kuniTN/rescue_tanaka_works/kicad/project/switching_board/screen shots/溶着画像2.jpg

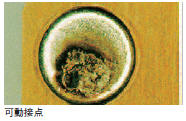
kicad/project/switching_board/screen shots/溶着画像2.jpg
