kuniTN/rescue_tanaka_works/kicad/project/switching_board/reference/ref3_トランジスタ・FETの選定_files/97f2e41f8781f32b32655e35a1a60c25.png

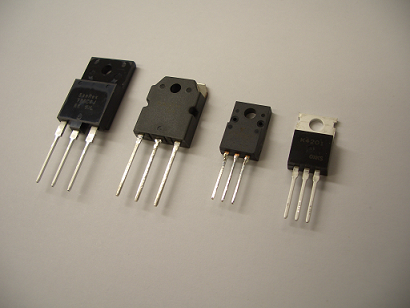
kicad/project/switching_board/reference/ref3_トランジスタ・FETの選定_files/97f2e41f8781f32b32655e35a1a60c25.png
