kuniTN/rescue_tanaka_works/README.md

# rescue_tanaka_works
 ここでは田中がレスキューロボット開発で身に着けてきた知見をもとに，今までの回路やプログラム等々を再設計，解説しています．
 新潟大学の非産業用ロボットプロジェクトの皆さんの基礎的な知識として身に着けていけるよう，なるべくわかりやすく解説をしていこうかと思っています
