kuniTN/rescue_tanaka_works/kicad/project/switching_board/スイッチング基板解説書.docx

1. はじめに

本ドキュメントは，[スイッチング基板_回路図v1.1.0_20210707.pdf]の回路についての
設計解説書です．

この回路は非産業用ロボットプロジェクトで開発中のレスキューロボット内に搭載することを“想定”し，既存の回路を再設計したものです．この回路はまだ作成・組込まれていないことに留意してください．

本ドキュメントでは，スイッチング基板について以下の項目を取り上げます．

- 基板の役割
- 回路設計
- 製造上の注意
- 設計者の考える追加改良案

電気的知識があまりない人にも可能な限り分かりやすく説明しているつもりです．

本ドキュメントの内容に関して不明点等あれば以下までご連絡ください．

送信先：田中邦明　アドレス：tkknnka1114@gmail.com

# 2. 基板の役割

## 2.1. ロボット全体における基板類の概略

まず基板の説明をする前に，図1にロボット全体の基板類の概略図を示します．

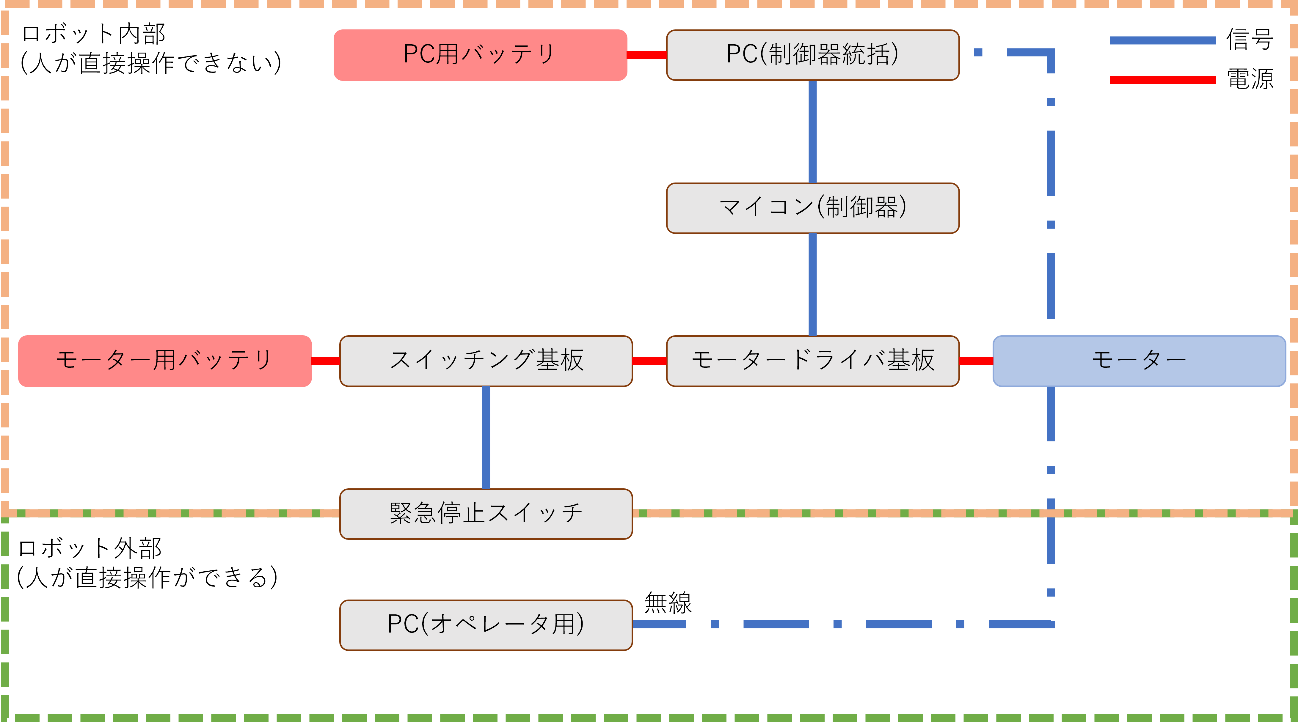
[picture p3: figure]

図1　ロボットシステム概略図

この中でスイッチング基板が接続しているのは

- モーター用バッテリ
- 緊急停止スイッチ
- モータードライバ基板（モーターを制御する基板）

の3つです．緊急停止スイッチが操作されたとき，バッテリからモータードライバ基板への電力供給が遮断され，ロボットが停止するようになっています．

## 2.2. スイッチング基板の役割

レスキューロボットに採用している緊急停止スイッチは図2のように，通常時は導通しており，緊急時にはスイッチを押し込むことで切断する仕組みになっています．

(大半の緊急停止スイッチはは押して切断するNCタイプですが，稀にそうでないものも)

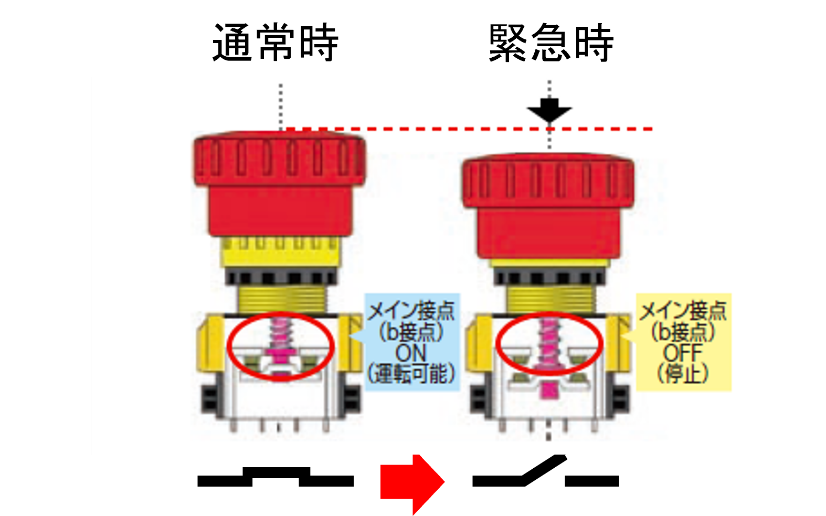
[picture p4: figure]

図2　緊急停止スイッチ内部構造

ならば，バッテリを直接緊急停止スイッチにつなげても同じことになるのでは？と考える人もいると思います．しかし，図3のようにつなげるのは場合によっては危険です．

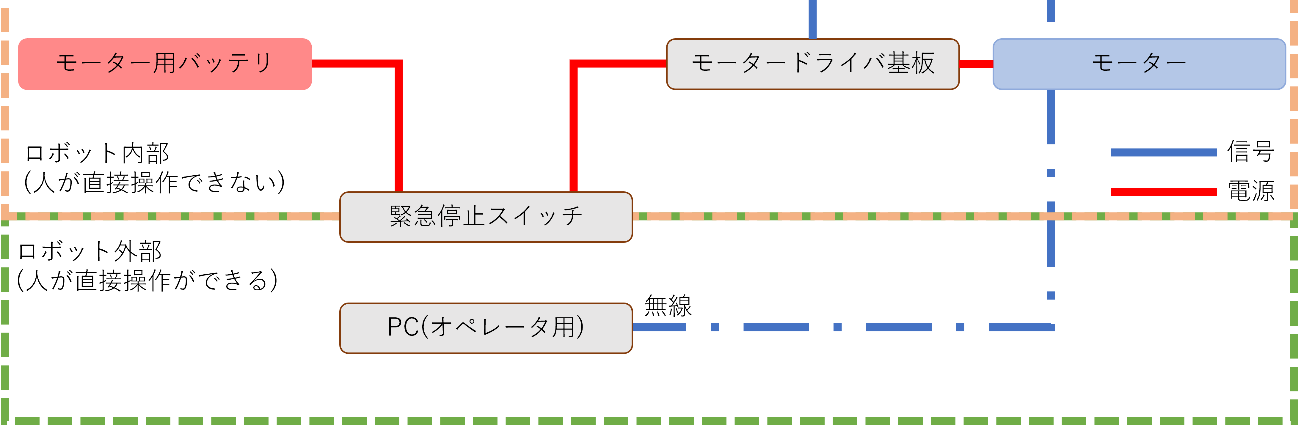
[picture p5: figure]

図3　バッテリ接続のダメな例

なぜダメなのでしょうか？それは，スイッチにも流せる電流の上限があるからです．

機械的な構造を持つスイッチは，接点部に抵抗があります．そのため電気が流れる際に接点部で発熱します．大電流が流れると異常発熱し，接点同士が溶けてくっついてしまう，つまり常にON状態に陥ります．そうなってしまってはスイッチの意味がありません．

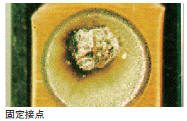
[picture p6: figure]

モーターは，動かすのに非常に大きな電流 (数A以上) が必要です．そのためバッテリとモーターの間に機械的スイッチをつなげてしまうと，スイッチを壊してしまう可能性が非常に高いです．

図4　スイッチ接点の溶解の様子

そこで大電流が流れる回路でもスイッチングを行うために，“電気的”スイッチを利用します．その名の通り，電気で電気のスイッチ操作するわけです．このような機能を持つ素子のことをトランジスタといいます．

トランジスタは機械的な構造を持たないので接点がなく，大電流のスイッチングを小電力で行うことができます．

（ここではトランジスタの原理については説明しません．
インターネット上に様々な解説資料がありますので，参考にしてください ）

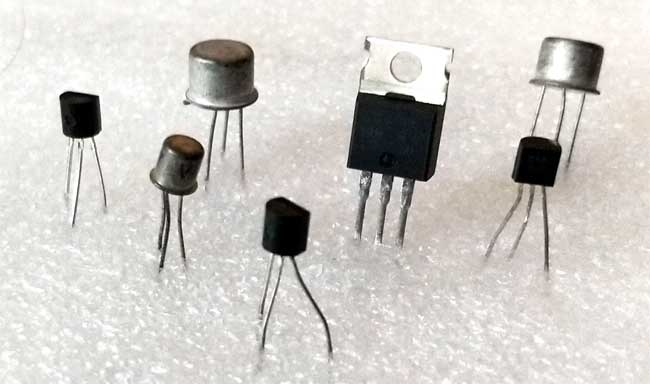
[picture p7: figure]

図5　トランジスタ

スイッチング基板はつまり，機械的スイッチで電気的スイッチの操作を行い，電気的スイッチがバッテリからの大電流を制御する基板です．こうすることで初めて，人が操作しやすい機械的スイッチを使って大電流を制御できるようになるわけです．

# 3. 回路設計

ここからは，設計者が作成した回路と合わせて詳細に説明していきます．

この回路は大きく分けて3つの領域に分かれています．

[スイッチング基板_回路図v1.1.0_20210707.pdf]を開き，適宜拡大等して確認してください．

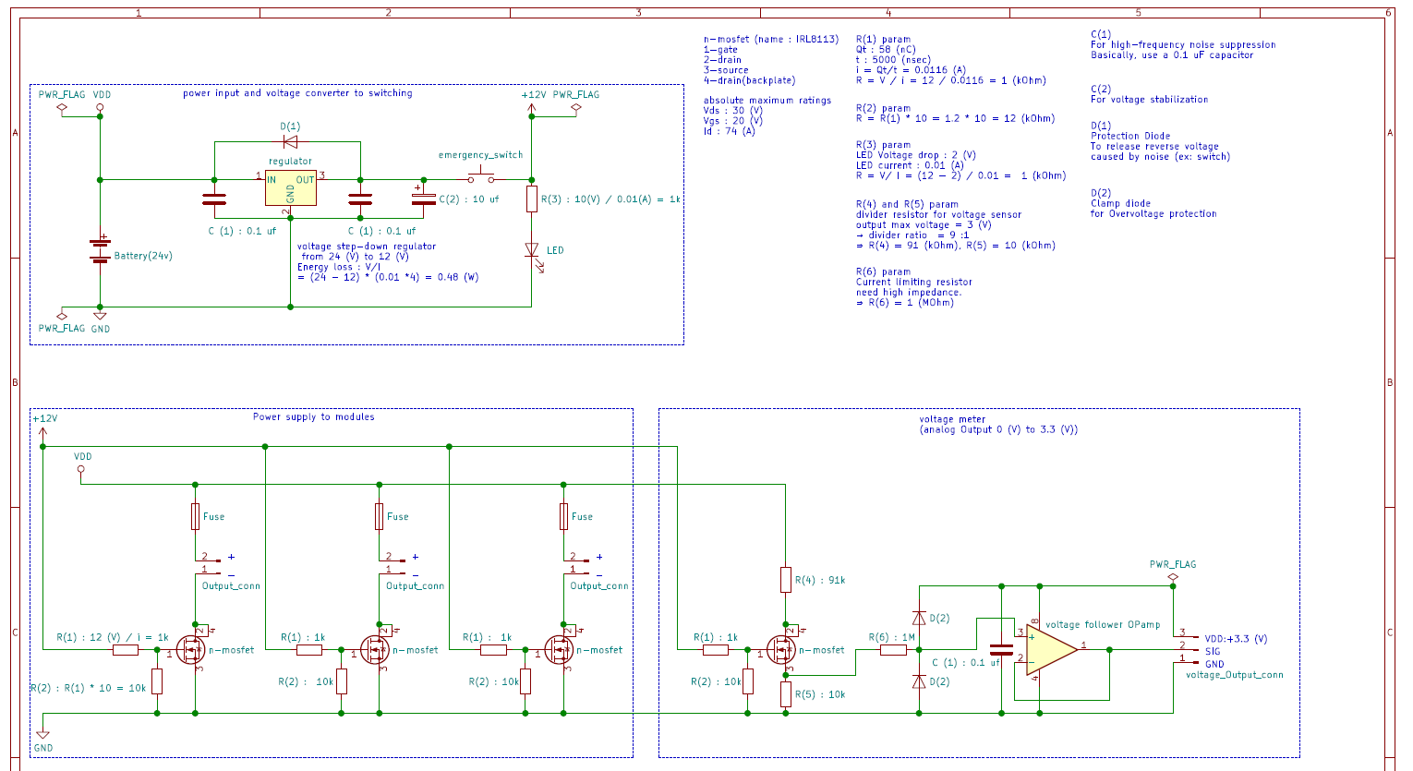
[picture p8: figure]

図6　回路図全体

## 3.1. 電源出力

まずはこの基板における最重要区画，電源出力部を見てみます．

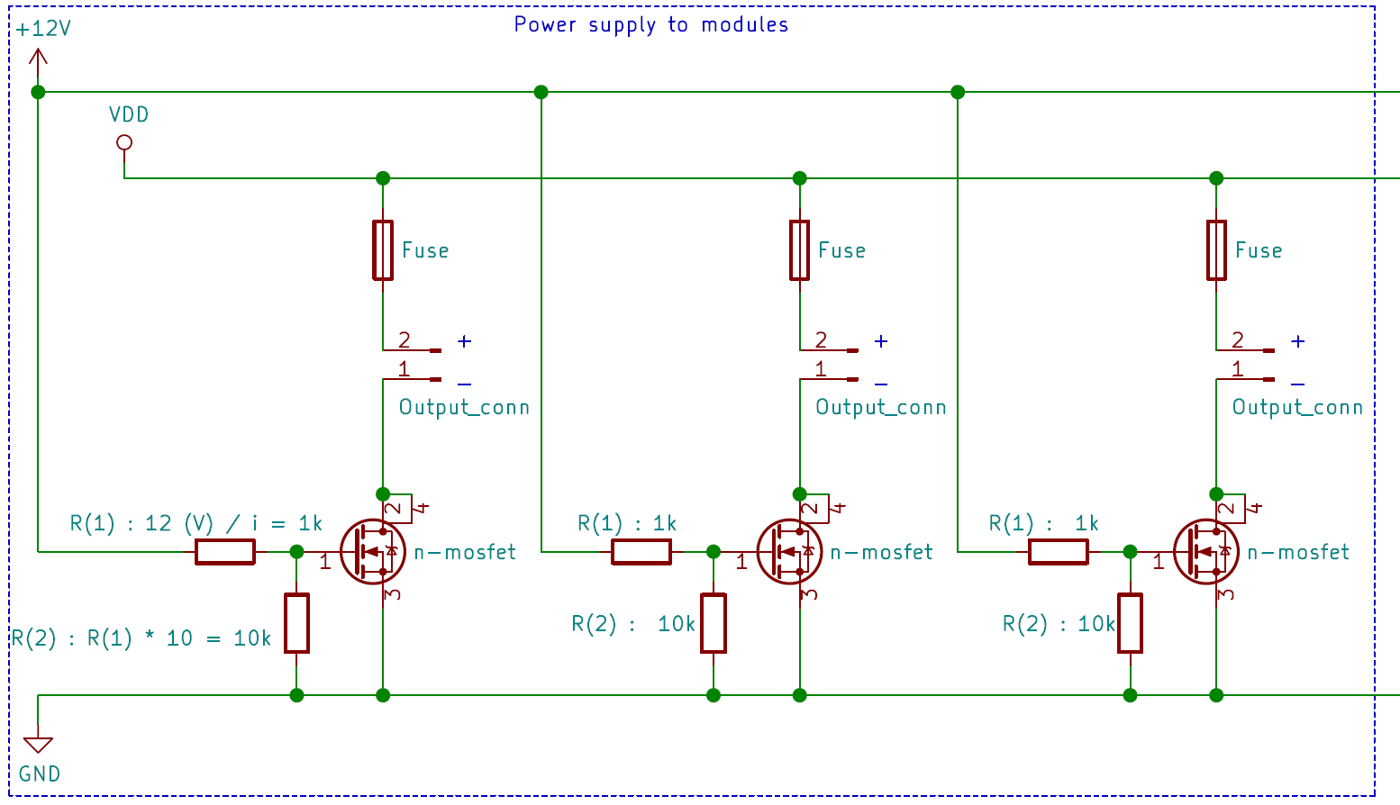
[picture p9: figure]

図7　電源出力部

この回路では，電源出力コネクタ(Output_conn)を3つ用意しています．このコネクタからモータードライバへ電力を供給します(図8)．

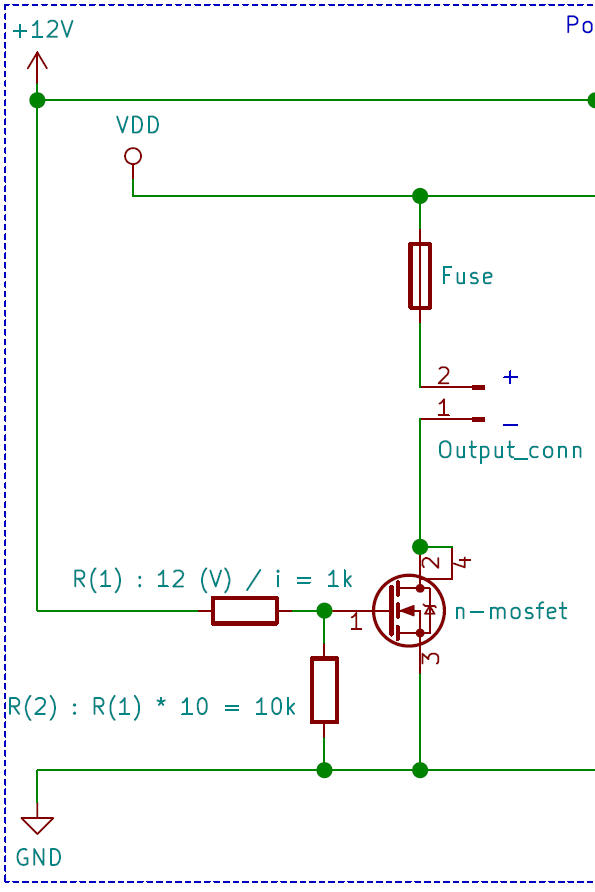
[picture p10: figure]

モーター

モータードライバ基板

図8　電源出力部(1 unit)

### 2.1.1 n-MOSFET

この基板における最重要素子でトランジスタの一種です．この素子によって電源のスイッチング操作を行います．

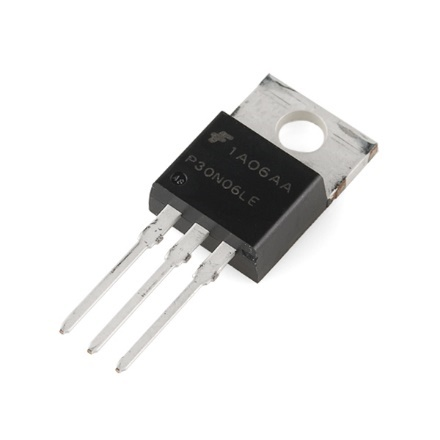
[picture p11: figure]

図9　MOSFET

MOSFETには2種類 (P channel, N channel) あります．どちらもスイッチング可能な素子ですが，若干使い方が異なります．普通に使う分にはN channelの方が使いやすいと思いますので，ここではN channelのMOSFETのみ解説します．

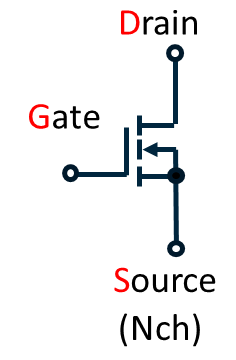
[picture p12: figure]

図10　n-MOSFET回路記号

n-MOSFETは，図9からわかる通り3つの端子が出ています．これらはそれぞれ，Drain, Gate, Sourceの端子となっています．モーター用バッテリの電流はDrainからSourceにかけて流れ，その流れをGate-Source間電圧によって制御します．

⇒　Gate-Source間電圧が0 V であればDrain-Source間は遮断

Gate-Source間電圧が閾値以上であれば，Drain-Source間が導通

MOSFETを選定する際には，耐圧，耐電流，Gate-Source間の閾値電圧に注意してください．この回路で使用を想定したIRL8113であれば，Drain-Source間の最大耐電圧は30V, 耐電流は74 A, Gate-Source間の耐電圧は20 V，閾値電圧は1.35 ~2.25 Vです．

参考サイト : https://ana-dig.com/transistor_fet/

### 2.1.2 ゲート抵抗

参考サイト : https://ana-dig.com/fet_gate1/

参考資料 : TOSHIBA MOSFET設計 (https://toshiba.semicon-storage.com/content/dam/toshiba-ss-v2/master/en/semiconductor/knowledge/faq/mosfet/MOSFET-Gate-Drive-Circuit-Application-Notes_JA_3626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)

n-MOSFETを使用するためには，Gate-Source間に電圧をかける必要があることを前項で説明しました．ここで回路全体を見ると，n-MOSFETには2つの抵抗が接続されていることがわかります．この項では，下図に示されている，スイッチからの
12 VとGate間に接続されている抵抗（ゲート抵抗）について解説します．

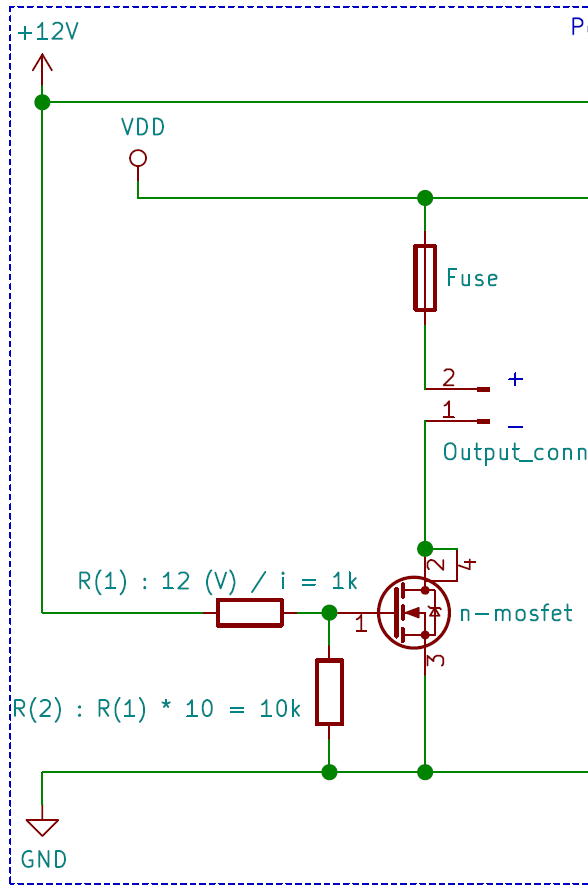
[picture p13: figure]

ゲート抵抗

図11　ゲート抵抗の位置

n-MOSFETのGate-Source間はコンデンサのような働きを持ち，このコンデンサが閾値電圧( V_(GS(Th)) )以上になった時，Drain-Source間が導通すると理解してください．
下図はn-MOSFETを他の素子で簡略的に示したものです．

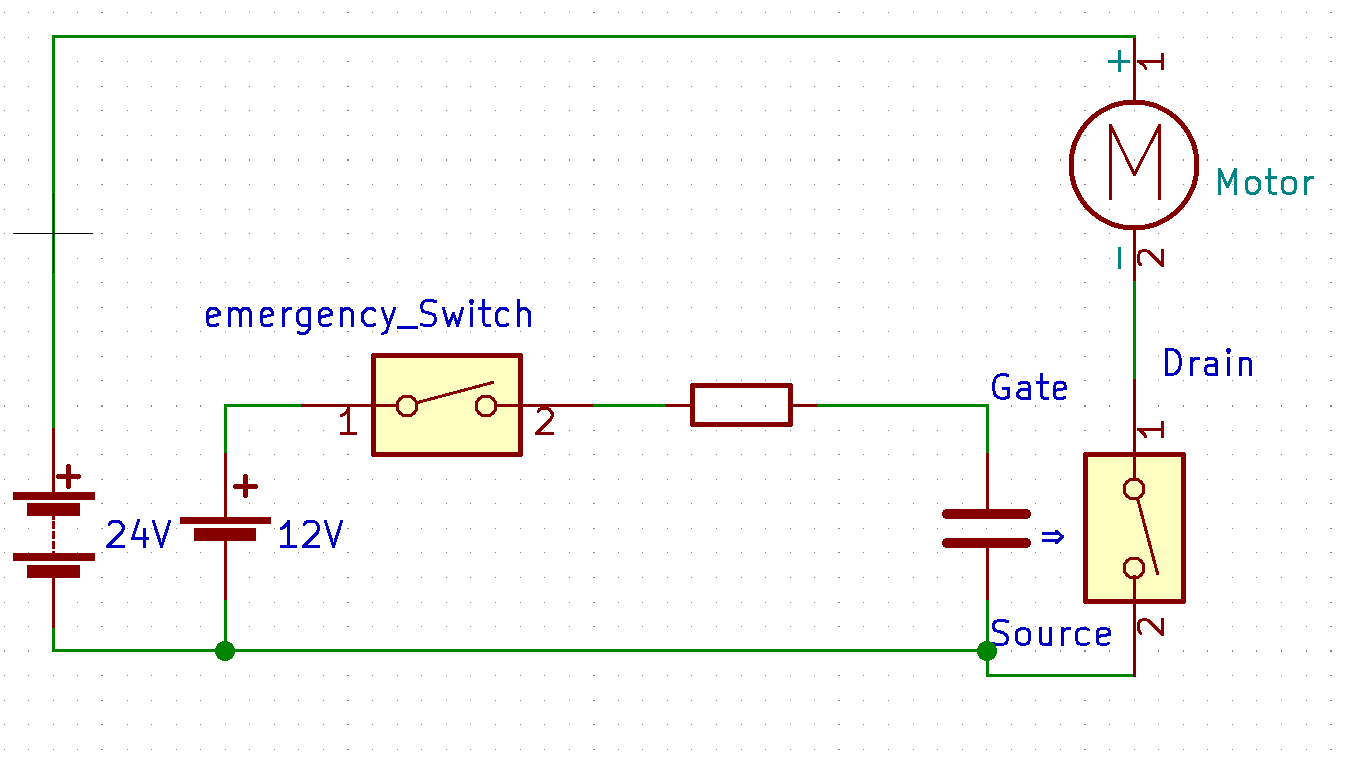
[picture p14: figure]

ゲート抵抗

if V_(GS) >V_(GS(Th)) :On

V_(GS)

図12　n-MOSFETの概略

ここでコンデンサの働きについて確認しましょう．

直流電源におけるコンデンサは，充電が空っぽの時，抵抗値は0（短絡）として考え，満充電の時の抵抗値は無限大（解放）と考えます．

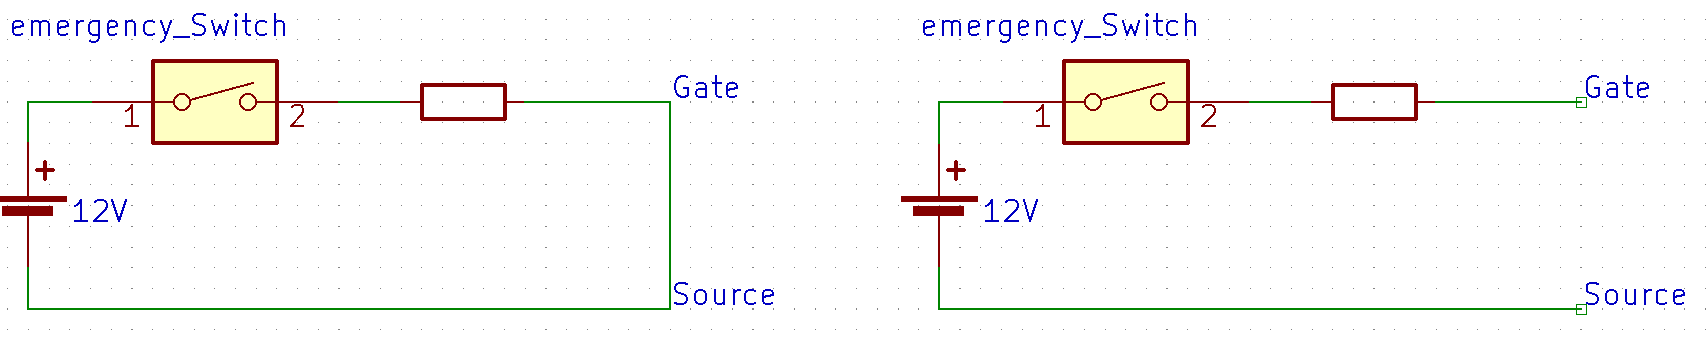
[picture p15: figure]

図13　コンデンサの充電状態による回路表現
左：コンデンサが空　右：コンデンサ満充電

仮にゲート抵抗がない場合，コンデンサが空ならば，バッテリがショートしていると考えることができます．この状態は無制限に電流を流せるということであり，バッテリが異常発熱したり回路を焼損させたりする要因になり非常に危険です．スイッチング用の電源回路(ドライブ回路)の保護のためにゲート抵抗が必要というわけです．

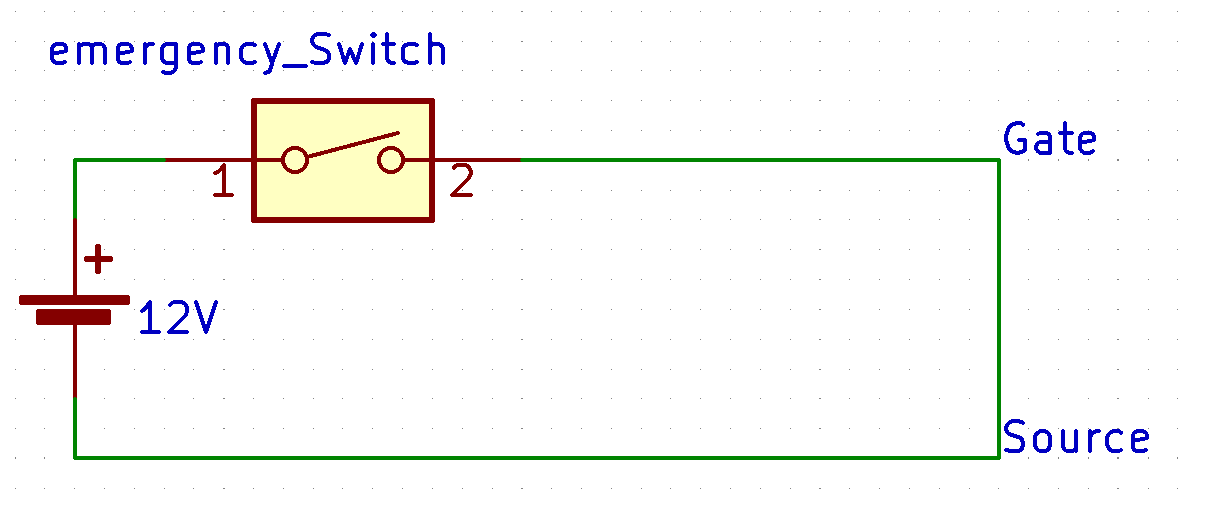
[picture p16: figure]

図14　バッテリがショートしている危険な状態

このようなつなぎ方をしては絶対にダメです

では次に，どの値の抵抗を使えばよいのかについて説明します．

先ほどn-MOSFETのGate-Source間はコンデンサのような役割を持つことを説明しました．コンデンサの充電速度は流れ込む電流量によって変化します．コンデンサの充電が早ければそれだけ早くDrain-Source間は導通します．

コンデンサの充電時間を計算するためには，Gateの電荷量 Qg を見ます．

n-MOSFETのデータシートより， Q_g -V_(GS) グラフを確認します．今回はIRL8113のパラメータを確認します．

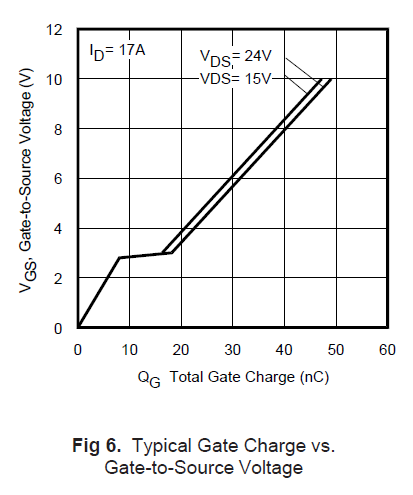
[picture p17: figure]

図15　n-MOSFETの Q_G -V_(GS) グラフ

今回の回路では， V_(GS) に12 Vを印加します．図15より， V_(GS) が12 V付近の Q_G を見ると，およそ58 nC と読み取れます．

(グラフが途中で切れているように見えますが，一般的にMOSFETは V_(GS) が10 Vで駆動することが基本のようで，このデータシートではそこまでしか記入されていないようです．今回の場合は直線を延長して考えて問題ありません)

Q はある電流 I をある時間 t だけ流した時の電荷量であり，(1)式で表されます．

, Q=I*t (I:電流量， t :時間)#(1)

ここからわかるように， Q_G が与えられている今，充電時間あるいは流す電流量を決定すればもう一方の変数が一意に定まります．今回は時間を5000 nsecと定めてみましょう．すると計算結果は(1)式より

, I_G =(Q_G)/t=(58*10^(-9))/(5000*10^(-9))=0.0116 (= 11.6 mA)#(2)

よって，(2)式よりGateに流れ込む電流量が11.6 mAとわかりました．

今回は時間 t を5000 nsecと定めましたが，この値は今までの制作経験則からであり，また最終的に計算結果の電流量が約10 mA程度になる範囲として定めたので，かなり適当です．精度が必要な回路であれば厳密に決定すべきでしょうが，今回は接続される機器にそこまで電気的な精度が求められていないので，ある程度適当で問題ありません．逆に電流量を定め，それにかかる時間を計算しても構いません．

(10 mAを流すと定めるなら，充電時間が5800 nsecとなります)

詳細な設計を行いたい場合はTOSHIBAの参考資料をご覧ください．

必要な電流量が求まったら，あとは単純なオームの法則で解くことができます．

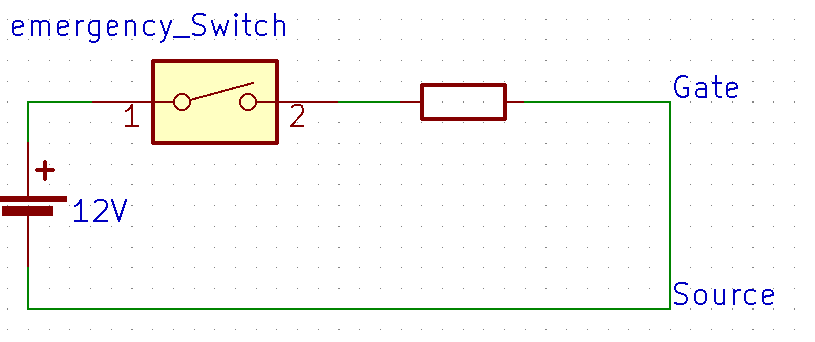
[picture p18: figure]

I=11.6 mA

図16　抵抗値計算

図16を見れば単純ですね．オームの法則(3)式より

, R=V/I=12/(11.6*10^(-3))=1034.4 ≈1 kΩ#(3)

この計算結果から，実際に販売されている抵抗を選択し， 1 kΩ をゲート抵抗として使用することが決定しました．

### 2.1.3 ゲートソース間抵抗

参考サイト : https://ana-dig.com/fet_gate2/

https://detail-infomation.com/mosfet-gate-to-source-resistor/

つぎにGate-Source間に並列して接続されているゲートソース間抵抗を考えます．

前項では，ゲートソース間抵抗はないものとして取り扱っていました．それはこの抵抗が持つ役割がゲート抵抗とは全く異なり，またゲート抵抗に対して非常に高い抵抗値のため電流路への影響が非常に小さいためです．

ゲートソース間抵抗

図17　ゲートソース間抵抗の位置

ゲートソース間抵抗の役割は，回路の安定性を高めるためです．

簡単な思考テストをしてみましょう．

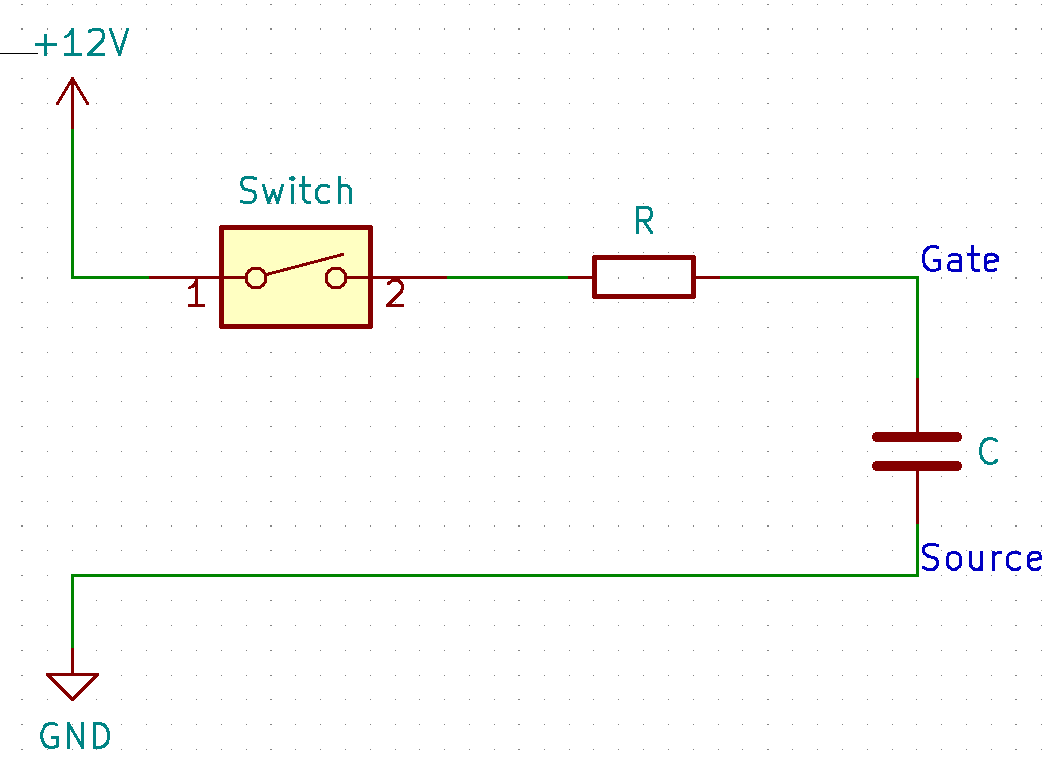
[picture p19: figure]

V_(GS) = ???

図18　n-MOSFET等価回路

図12の回路上のスイッチがオフ，つまり回路がつながっていない場合を考えます．

スイッチがオフだからといって，Gateの電圧が0Vとなることが決まるわけではありません．そもそも電圧の基準となる0 VというのはGND線の電位のことであり，高電位をもつ電圧源からGNDにつながる回路があって初めて電圧が決まります．スイッチがオフであるため，回路として不成立であり，そもそも電圧を規定できません．このような状態を電気回路の世界では配線が「浮いている」と表現する様です．

また，Gate-Source間をコンデンサで表現したように，Drain-Source間のスイッチをオフにするためにはコンデンサ内の電荷を逃がしてやる必要があります．しかし図12の回路ではコンデンサにたまった電荷を逃がす経路が存在しません．

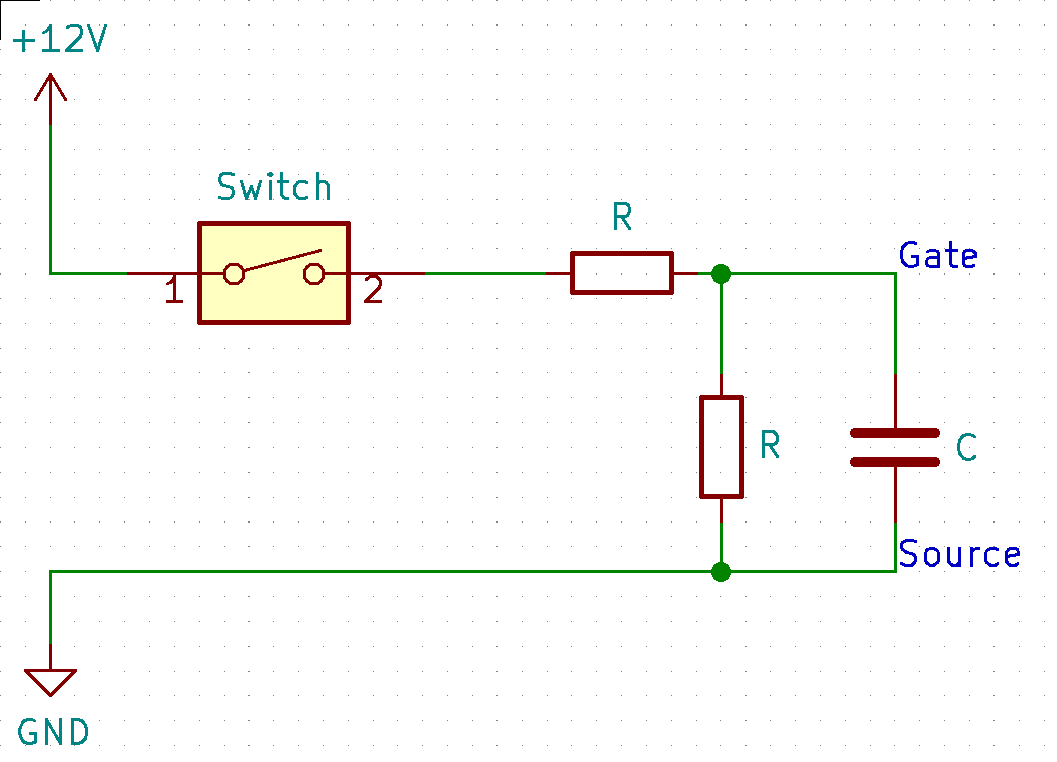
[picture p20: figure]

コンデンサからの放電

図19　ゲートソース間抵抗つき回路

図19のように，ゲートソース間と並列に抵抗をつなげることで，スイッチがオフになったとしても，ゲートソース間のコンデンサにはGNDとつながる経路が出来上がり，コンデンサの電荷を逃がすことができ，Gateへの電位を0Vに保つことができるようになります．この抵抗があることで，n-MOSFETを確実に電源オンオフできるようになります．

では次に，どの値の抵抗を使えばよいのかについて説明します．

初めに説明したように，この抵抗は電流を流すことを目的とはしていません．
そのため電流はあまり流さず，電圧は小さくなるようにゲート抵抗に対して十分に大きい抵抗値に設計します．

大きすぎると今度はコンデンサからの電荷の放出に影響を与えるため，ある程度の大きさにとどめる必要があります．

まず，ゲート電圧 V_(GS) の電圧とドレイン電流 I_D のグラフを見て， V_(GS) に印加する電圧の下限を検討します．

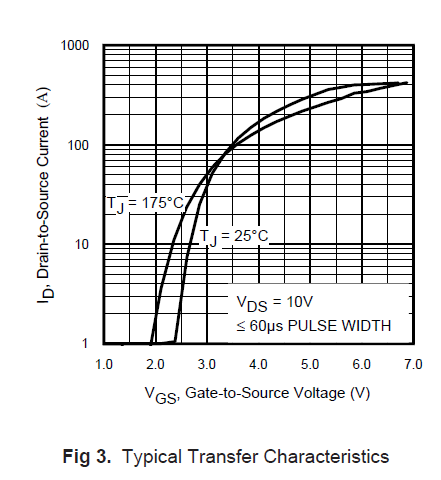
[picture p21: figure]

図20　 V_(GS) -I_D グラフ

図20より， V_(GS) が7V以上ならば， I_D が飽和することがわかります．ですので， V_(GS) の最低電圧を7 V とし，抵抗値を決定してみましょう． V_(GS) の電圧源は12 V なので，ゲート抵抗 R_G とゲートソース間抵抗 R_(GS) の比は，分圧の関係から
, R_G :R_(GS) =5:7#(4)

と定まります．今回 R_G は前項より1 kΩ と定めたので， R_(GS) は最低1.4 kΩ にすればよいです．しかし，この抵抗値は最低限ですので，これよりも大きい抵抗値を設定しておけば， V_(GS) が7 Vを下回ることはありません．

参考サイトではつぎに， V_(GS) の電圧源が流せる電流量について検討していますが，今回の場合は，ここで用いる電流量の限界はひとまず無視できるものとして考えます．もしスイッチング用電圧源をマイコン等から供給する場合はここも十分に検討しましょう．

次に，ドレインに急激に電圧が加わった時に流れてしまうノイズ電流の影響を検討します．しかし，ノイズ電流が実際どれくらい流れるかは不明です．そのため，ある程度の抵抗値を設定しておき，エラーが発生した際に調整するのが現実的と思われます．

以上より，(4)より R_(GS) には最低1.4 kΩ の抵抗を用いればよいことがわかります．今回はゲート抵抗 R_G の10倍の値として10 kΩ と定めました．この抵抗値であれば V_(GS) が閾値を超えるために必要なノイズ電流は0.15 mAとなります．

バッテリ電源を印加したとき，一瞬モータードライバに電源が入る場合はノイズ電流で V_(GS) が閾値を超えてしまっていることになるので， R_(GS) の抵抗値をより小さくする必要があります．

### 2.1.4 ヒューズ

参考サイト : https://www.socfuse.com/ja/technical-info-data/3509/

この回路には各MOSFETにヒューズを搭載しています．このヒューズの目的は，モータードライバへの出力段以降で発生したショートなどに対する対策として取り付けています．バッテリ保護用ではないことに注意してください．

ヒューズの選定は，本来であれば非常に厳密な測定に基づいて決定されるべきものです．（参考サイトをご覧ください）

ですが現時点でヒューズの選定に必要な情報はほぼ得られていません．各モータードライバ以降で消費する電流，電圧の時系列データが必要ですので，今後それらの計測が必要です．現時点ではお守り程度に思っておいてください．

## 3.2. 電源入力

電源入力を受ける部分は以下の回路図になっています．

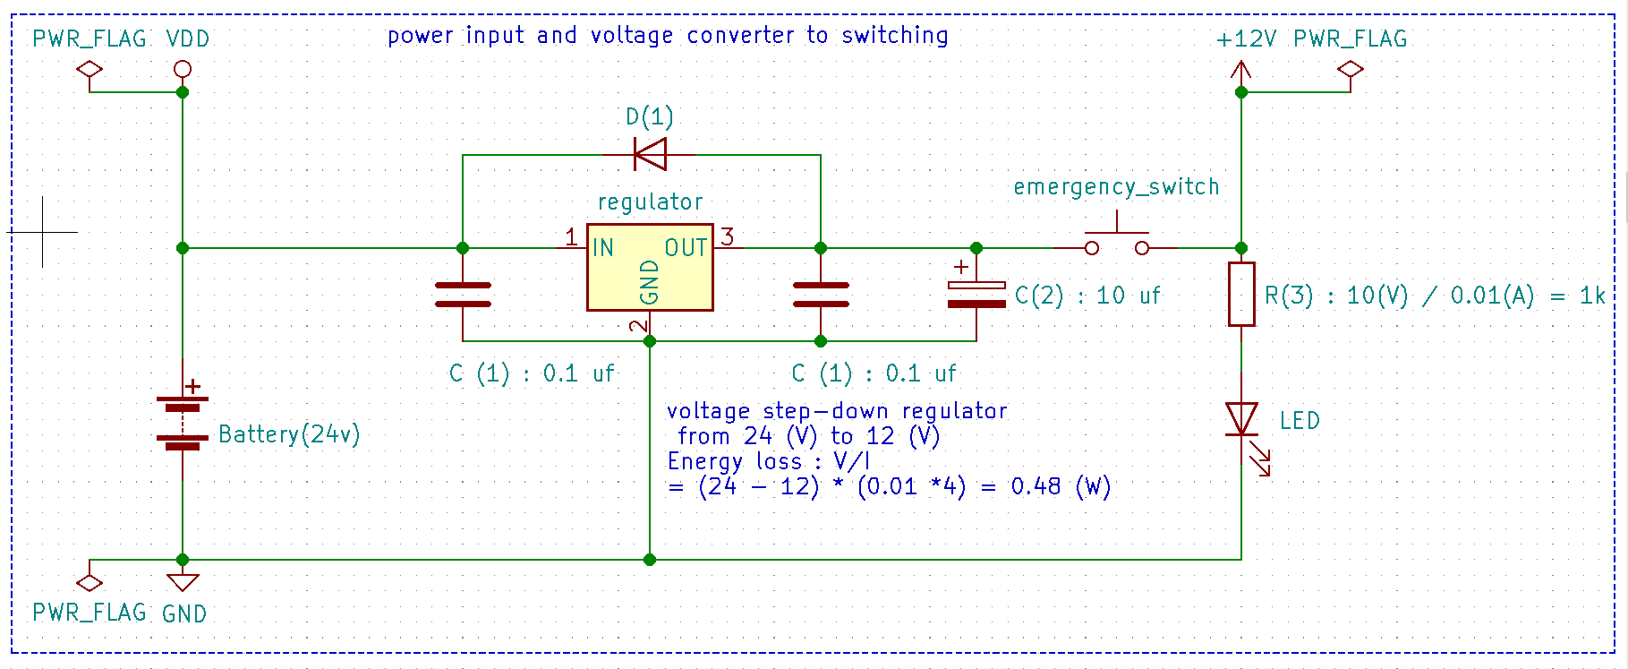
[picture p22: figure]

図21　電源入力段　
(回路上のPWR_FLAGは回路には無関係です)

画面左側にあるBatteryがモーター用に用意しているLi-Poバッテリです．ここからVDDにつながり，前項で説明したMOSFETのDrainへ流れ込みます．

ここではバッテリから右側へつながっていっている回路について解説します．

### 3.2.1. 3端子レギュレータ

図22　3端子レギュレータの位置

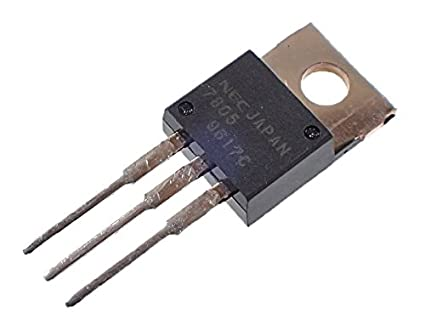
[picture p23: figure]

図23　3端子レギュレータ

図22の丸で囲んだ部分が図23に示された3端子レギュレータと呼ばれる素子です．バッテリの右側回路は基本的にすべてこの端子を動かすために必要なコンデンサ類です．

3端子レギュレータとは，入力された電圧を，指定された電圧に変圧してくれる
素子です．今回はバッテリからの24 Vを12 Vに降圧するために用いています．

なぜ12 Vに降圧しているのか？それは使用しているn-MOSFETの V_(GS) 絶対定格が最大 20Vであったためです．バッテリからの電圧をそのまま入力してしまうとn-MOSFETを破壊してしまうため，降圧する必要があるわけです．

降圧するだけなら，分圧用の抵抗を直列つなぎにしてもよさそうですが，今回の電圧源であるモーター用バッテリは，モーター駆動時に大電流を流すため，一時的に電圧が大きく変動します．この時，降圧する為に抵抗を用いていた場合は，その電圧変動の影響を直接受け，結果としてn-MOSFETの動作を不安定化させてしまいます．これを防ぐために安定的に電圧を供給することのできる3端子レギュレータを採用しました．

3端子レギュレータの両端にはコンデンサがついています．これらはどちらも電圧安定化，ノイズ除去のための素子です．本来ならば，左側にももう一つ容量の大きいコンデンサを配置したいところですが，先ほど説明した通りモーター用バッテリは，モーター駆動時に大電流を流すために電圧変動が大きく，多少容量の大きなコンデンサを配置してもあまり効果をえられないと考えられたので省略しています．

（ノイズ除去用コンデンサについての詳細はここでの説明は省きます．基本的には使用する3端子レギュレータの仕様書に従って問題ありません．）

### 3.2.2. LED

LEDがemergency Switchの後に接続されています．このLEDはモータードライバ等への電源供給が行われていることを示すインジケータです．

LEDの抵抗値の決定は，LEDの電圧降下を意識して設計する必要があります．LEDは一般に1~2 Vの電圧降下を引き起こします．今回LEDへ与えられる電圧は12Vですので，抵抗にかかる電圧は12 – 2 = 10 V です．今回LEDへ流れる電流は10 mAと定め，抵抗値はオームの法則より，1 kΩ としました．

## 2.3 電圧監視回路

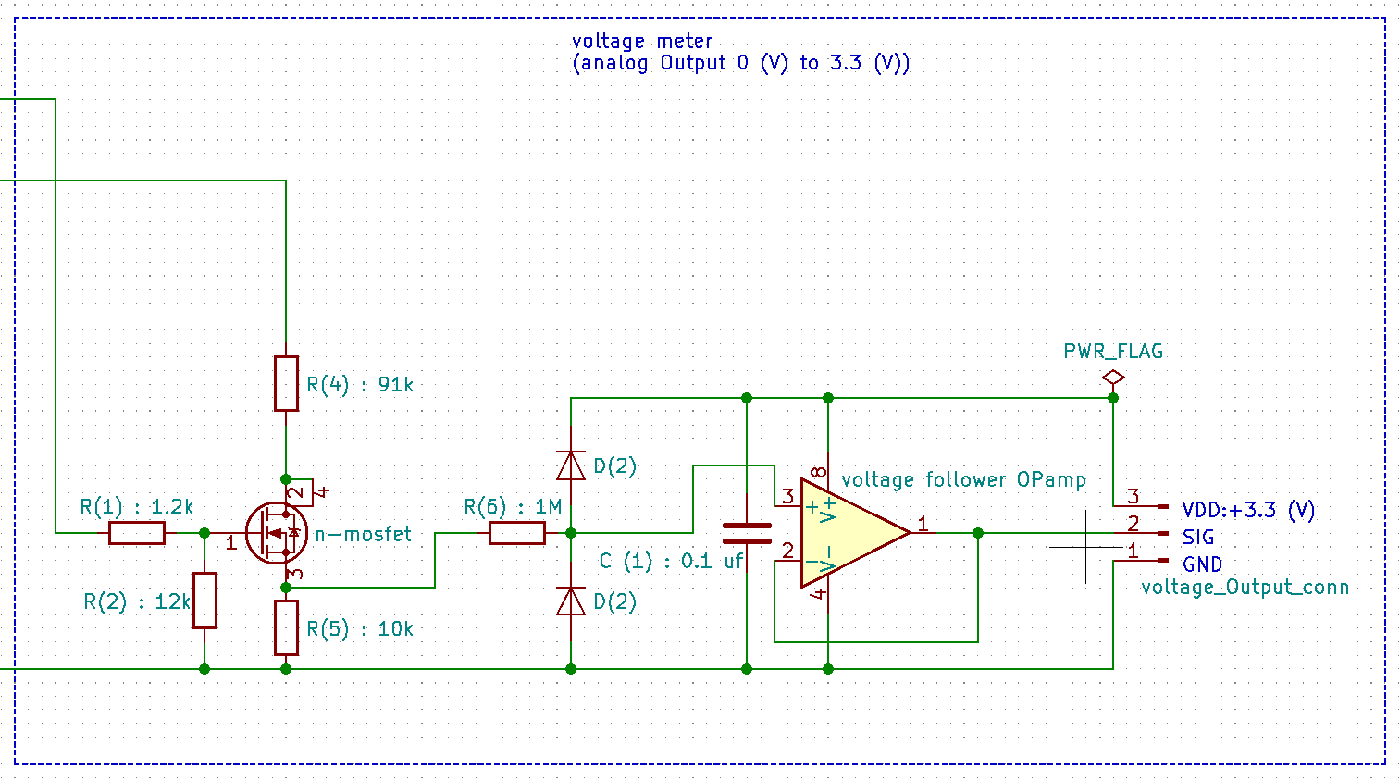
[picture p24: figure]

図24　電圧監視回路

電圧を監視するために作成した回路です．この回路は大きく分けて次の3つの回路に分割されます

- 分圧回路
- クランプ回路
- ボルテージフォロア回路

クランプ回路，ボルテージフォロア回路は両方ともマイコン保護用回路です．

それぞれ確認しながら解説します．

### 2.3.1. 分圧回路

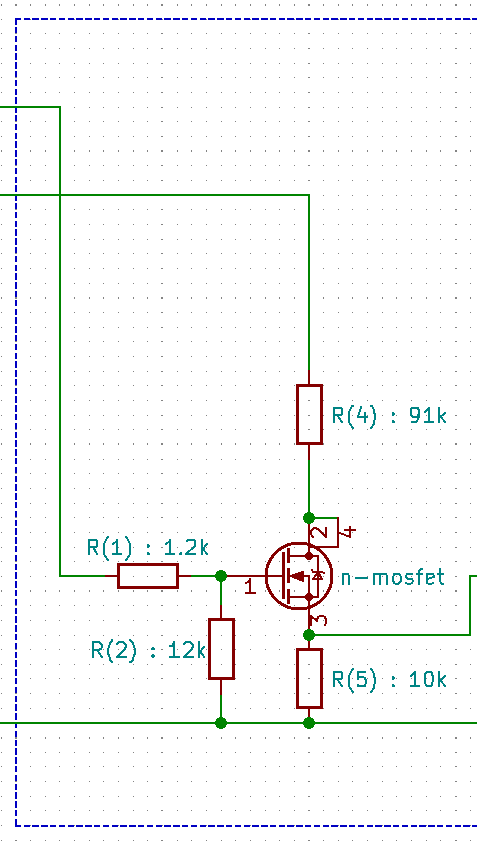
[picture p25: figure]

図25　分圧回路

2.1章で解説したn-MOSFETを利用した回路で，ヒューズを排し，その代わりに抵抗が２つ導入されています．

この２つの抵抗は，およそ9:1の比になるように設計しています．これは入力電圧が最大30Vの時，出力電圧が3 Vになるようにするためです．入力電圧を最大30Vとしたのは，安全率のためです．マイコンが壊れると制御系がすべてダウンしてしまうため，余裕を持った安全率を設定する必要があります．また出力電圧が3Vとした理由は，マイコンが計測できる電圧値の範囲が0~3.3 Vとなっているためです．

ここはただの分圧回路ですので解説は省略します．

### 2.3.2. クランプ回路

参考資料 : A-Dコンバータとアナログ入力のインターフェース (https://www.cqpub.co.jp/hanbai/books/42/42101/42101_6syo.pdf)

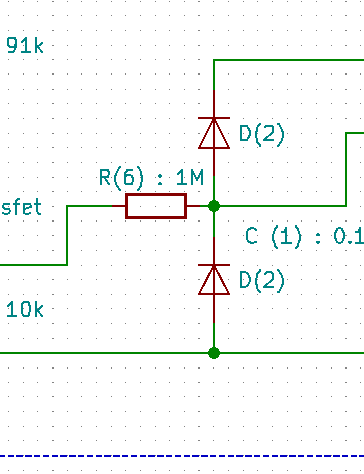
[picture p26: figure]

入力

GND

出力

3.3 V

図26　クランプ回路

入力から出力への経路を赤い線で示す

クランプ回路とは保護回路の一つで，入力された電圧を，設定した電圧の範囲に補正する回路です．図26のように，入力から出力への経路を二つのダイオードで挟み込む(クランプ)ような形となっています．入力から出力の電圧は前述の通り基本的に0~3Vとなっているので，二つのダイオードは逆方向の電圧がかかっています．そのため基本的にはこれらのダイオードは働きません．

これらのダイオードが働くのは，入力電圧が0Vを下回るとき(逆電圧)，あるいは3.3Vを上回るときです．先の設計が正しく働いていれば，これらの電圧になることはありませんが，何かしら異常が発生した場合はこれらの電圧を超えることが考えられます．その時にはそれぞれのダイオードが順方向となり電流が流れだし，電圧を変化させます．その結果として出力電圧を0~3.3Vの範囲内に収めることができます．

入力から出力の経路内に存在する抵抗は，電流制限用の抵抗です．この後解説するボルテージフォロア回路には(理論的には)電流が流れません．そのため通常は電流が流れませんが，先ほどの保護回路が働く際には電流が流れます．ただし，この電流が流れることによって，前段の分圧抵抗のインピーダンスが低くなり，正確な電圧計測ができなくなります（後述）．そのためなるべく電流を流さないように非常に大きい抵抗を用いています．

### 2.3.3. ボルテージフォロア回路

参考サイト : https://detail-infomation.com/voltage-follower/

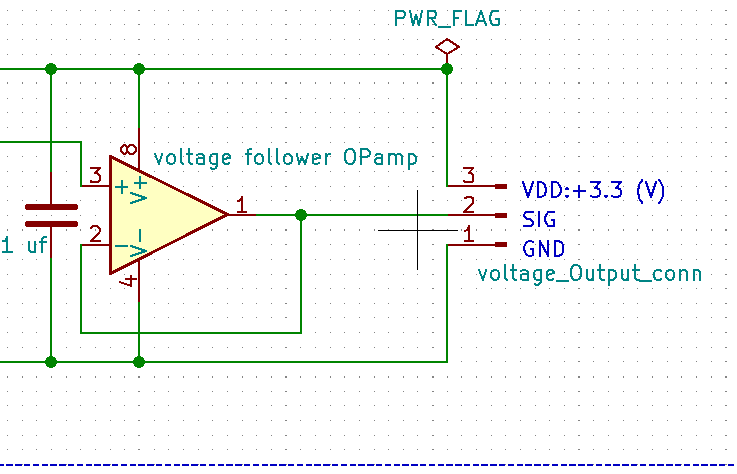
[picture p27: figure]

図27　ボルテージフォロア回路と出力端子

ボルテージフォロア回路とはオペアンプを用いた回路で，入力された電圧を増幅率1で出力する回路のことです．

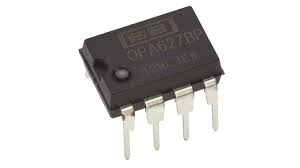
[picture p28: figure]

図28　オペアンプ

オペアンプとは一般に入力された信号を増幅するなどといった働きを持つ素子で，よく音声波形信号を持つ微弱な電圧を，スピーカーなどで出力できる程度の電圧に増幅したりなどで使われます．

オペアンプは，回路の組み方次第で様々な働きをします．今回はいくつかある回路のうち，ボルテージフォロア回路と呼ばれる回路を採用しています．

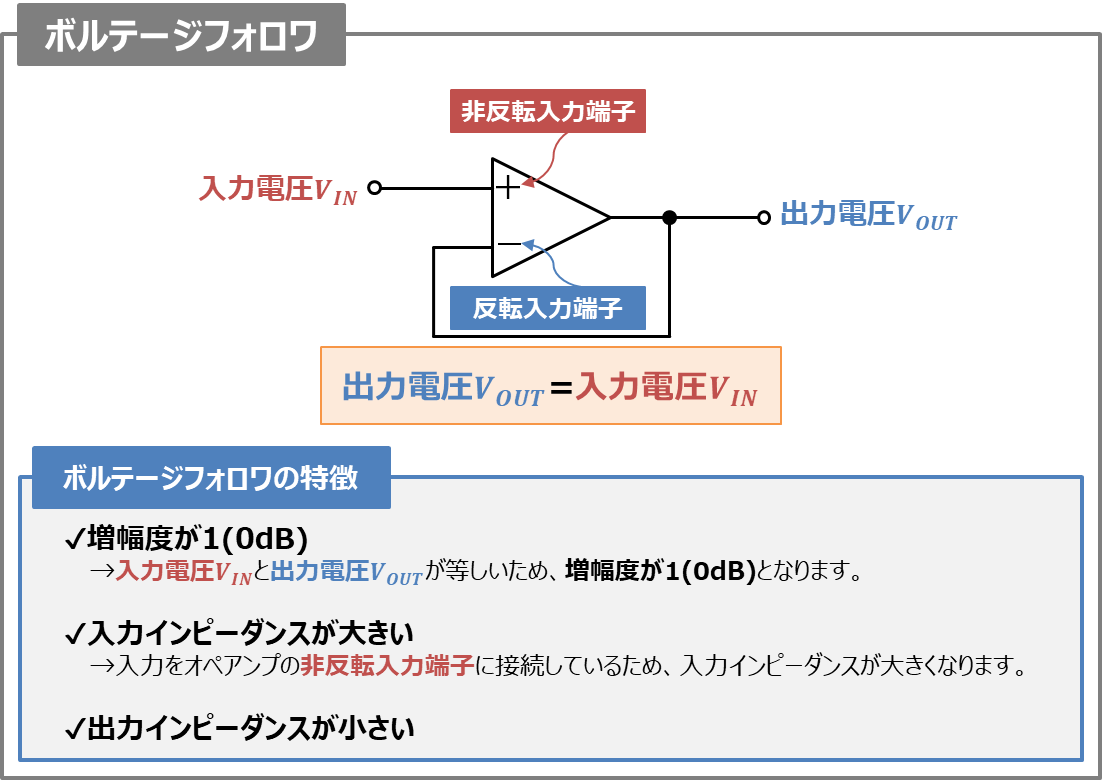
[picture p29: figure]

図29　ボルテージフォロア回路の説明

ボルテージフォロア回路の特徴は図29に示している通りです．入力された電圧をそのまま出力することができる回路なのですが，そのまま電圧を伝えるだけならただ導線をそのままつなげれば同じことが可能ですね．なぜただ導線でつなぐのではなくわざわざこの回路を導入しているのでしょうか？

その理由は図29に書いてある通り，入力インピーダンスが非常に高いことが理由です．クランプ回路の項で抵抗値の説明した際，電流が流れることでインピーダンスが低下し正しく電圧計測ができなくなることを説明しました．ここについてもう少し簡単に説明します．

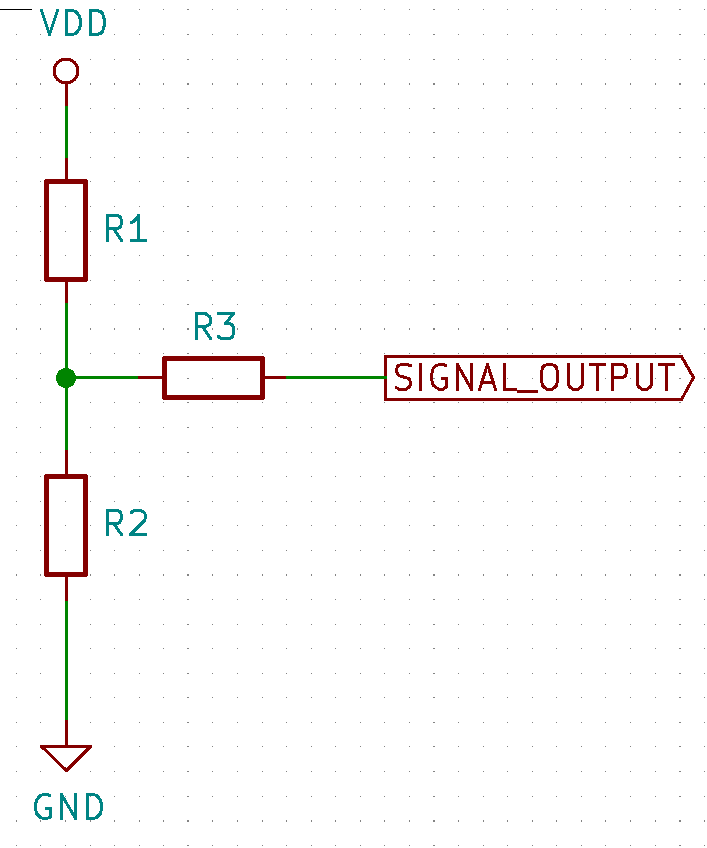
[picture p30: figure]

図30　分圧回路の模擬図

図30は図24の回路から余計なものを排した回路です． V_(DD) がR1,R2の二つの抵抗によって分圧され，R2の電圧がR3を通ってSIGNAL_OUTPUT，つまりマイコン等の制御機につながります．SIGNAL_OUTPUTのその先にはGNDがつながっていると想像してください．

さて，ここで簡単な思考テストをしてみましょう．この時，R1に流れる電流が(わかりやすく)1Aだったとしましょう．この時，R2の電圧はいくつになるでしょうか？

もし仮に，R1に流れる電流がすべてR2へ流れたとするならば（＝R3抵抗がないものとして見ることができるので），R2の電圧は単純に

, V_(R2) =V_(DD) *(R_2)/(R_1 +R_2)#(5)

で計算できますね．(5)式であれば正しく分圧していることを理解できるかと思います．

しかし，R3へ電流が流れると，R2,R3の並列抵抗となり，R2の電圧は，

, V_(R2) =V_(DD) *((R_2 R_3)/(R_2 +R_3))/(R_1 +(R_2 R_3)/(R_2 +R_3)) #(6)

のようになります．こうなると設計通りの分圧ができず，正しく計測できなくなってしまいます．(6)式のようにならないためには，R3へ流れる電流が無いようにする必要があります．電流を流さないようにするということはつまり，R3が無限大の抵抗値(インピーダンス)になればよいですね．

オペアンプは理想的な基本特性の一つとして，入力インピーダンスが無限大となる特性があります．つまり，入力電流が０となります．電圧計測にうってつけの素子なわけです．
