kuniTN/rescue_tanaka_works/kicad/project/switching_board/reference/MOSFETにゲートソース間抵抗が接続されている理由 _files/fy22q2w2_sit_pl_pl_svr_15g_HD_v2_300x250.jpg

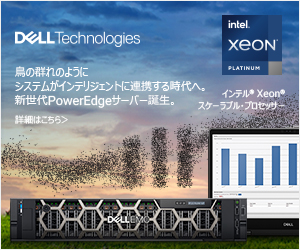
kicad/project/switching_board/reference/MOSFETにゲートソース間抵抗が接続されている理由 _files/fy22q2w2_sit_pl_pl_svr_15g_HD_v2_300x250.jpg
