kuniTN/rescue_tanaka_works/kicad/project/switching_board/reference/MOSFETにゲートソース間抵抗が接続されている理由 _files/MOSFETが誤ってオンしてしまうとどうなるのか.jpg

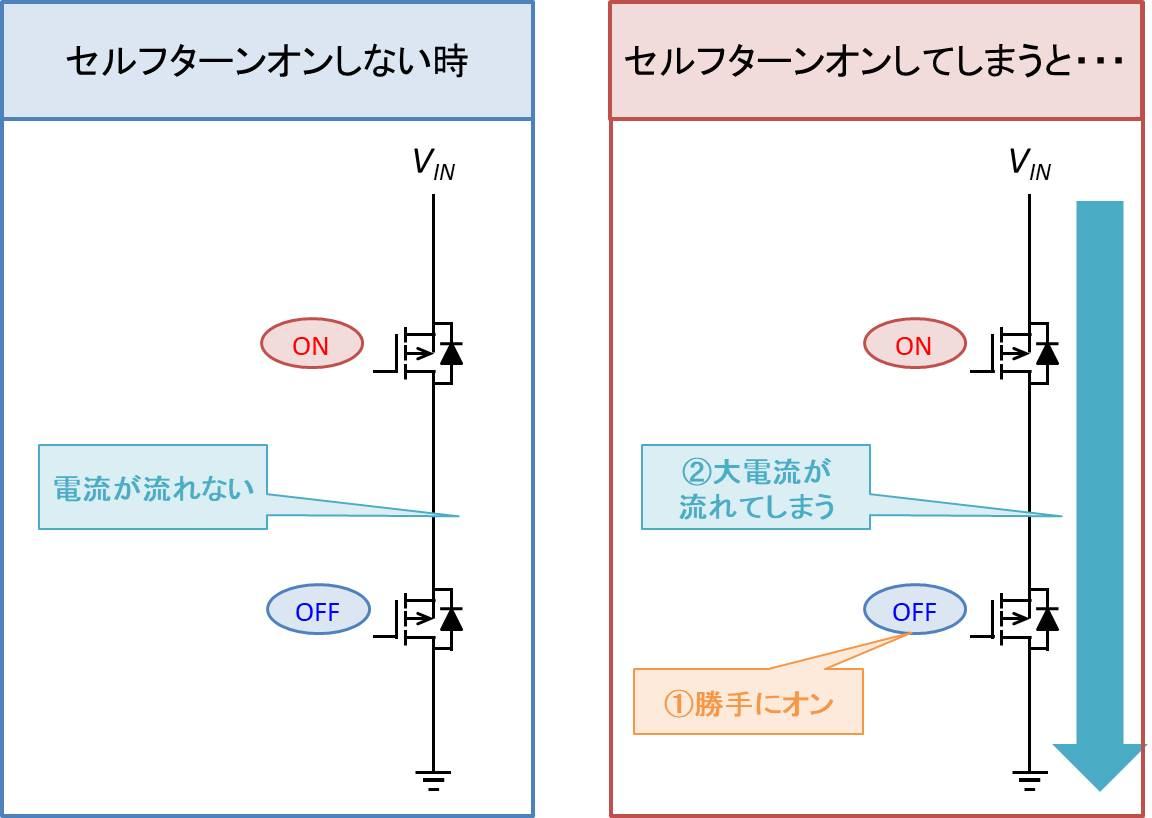
kicad/project/switching_board/reference/MOSFETにゲートソース間抵抗が接続されている理由 _files/MOSFETが誤ってオンしてしまうとどうなるのか.jpg
