kuniTN/rescue_tanaka_works/kicad/project/switching_board/reference/MOSFETにゲートソース間抵抗が接続されている理由 _files/MOSFETにゲートソース間抵抗を接続する理由１.jpg

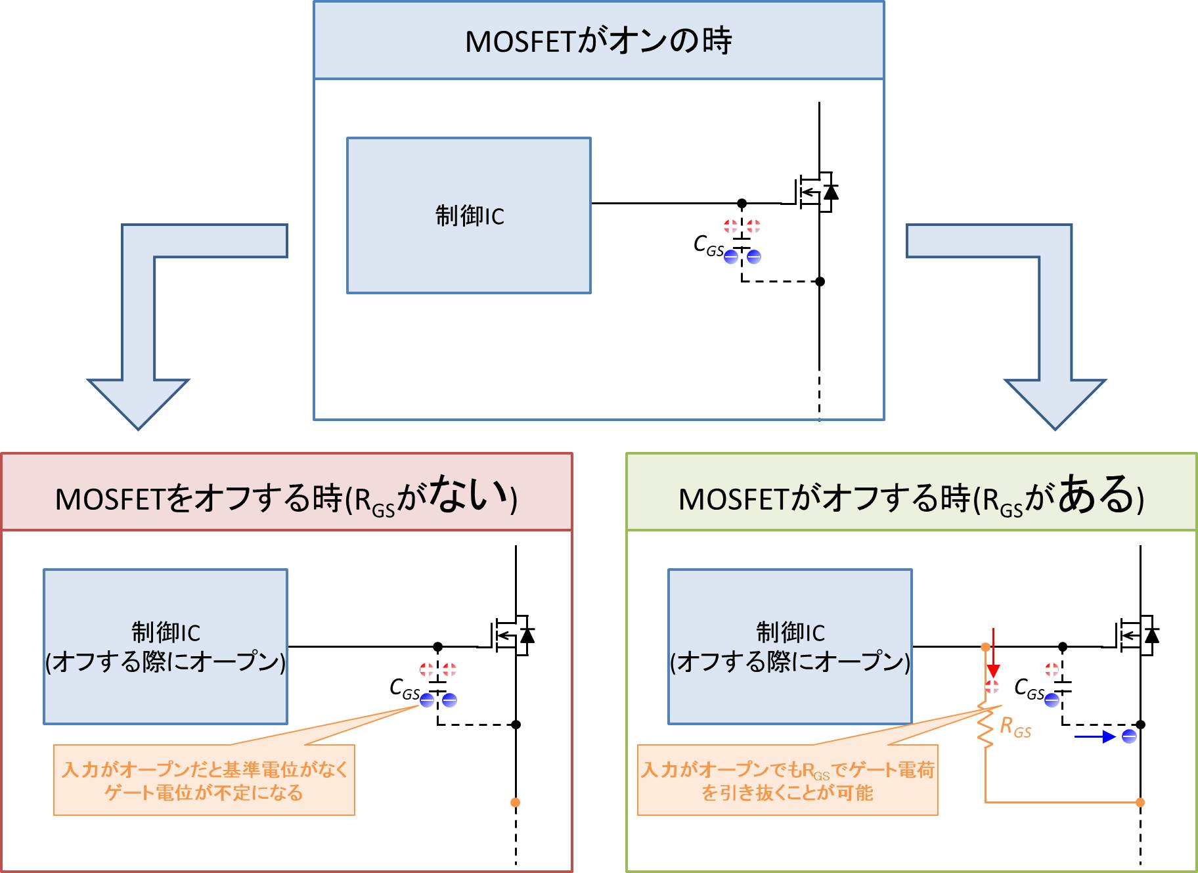
kicad/project/switching_board/reference/MOSFETにゲートソース間抵抗が接続されている理由 _files/MOSFETにゲートソース間抵抗を接続する理由１.jpg
