kuniTN/rescue_tanaka_works/kicad/project/switching_board/reference/MOSFETにゲートソース間抵抗が接続されている理由 _files/ゲートソース間抵抗の呼び方.jpg

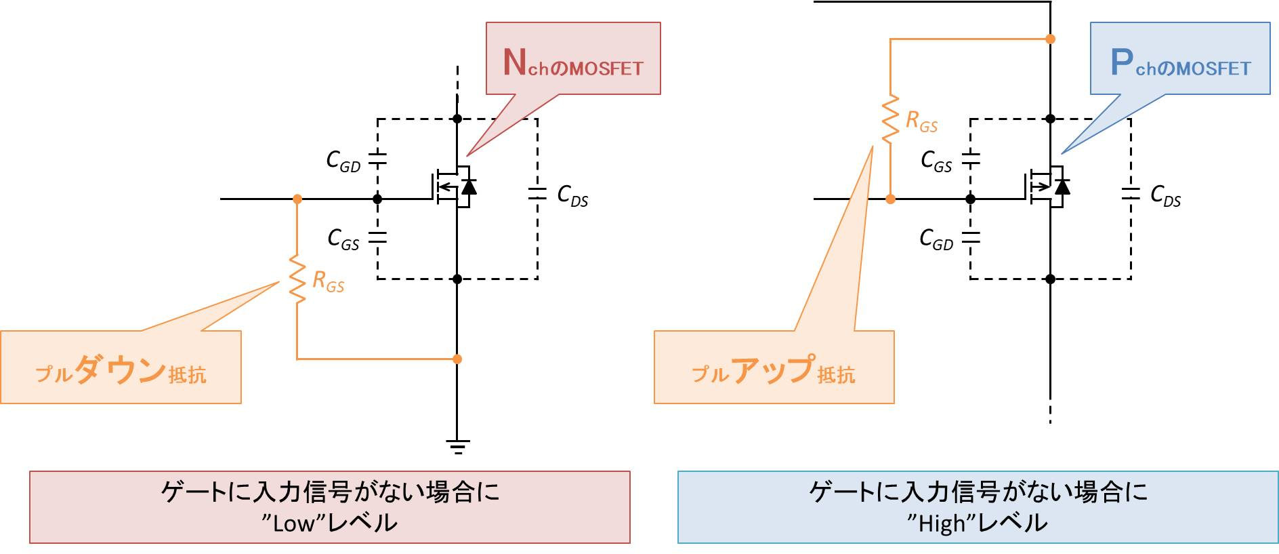
kicad/project/switching_board/reference/MOSFETにゲートソース間抵抗が接続されている理由 _files/ゲートソース間抵抗の呼び方.jpg
