kuniTN/rescue_tanaka_works/kicad/project/switching_board/reference/ref1_FETのゲート抵抗の決め方_files/0c2d23aab0f83973fe822a5a956ac8af.png

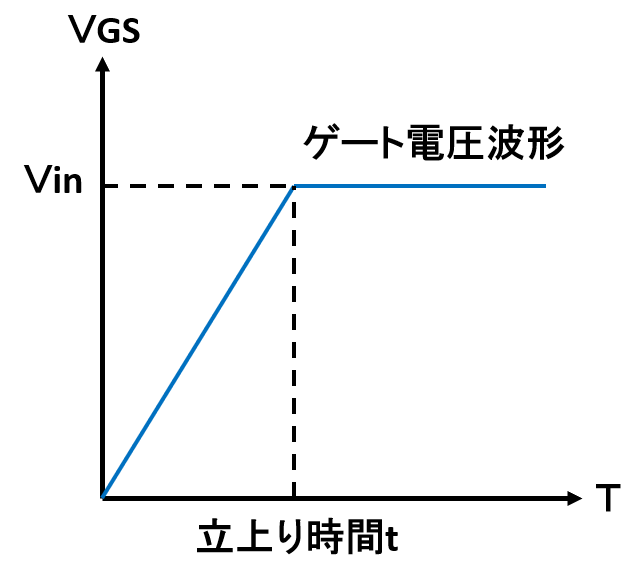
kicad/project/switching_board/reference/ref1_FETのゲート抵抗の決め方_files/0c2d23aab0f83973fe822a5a956ac8af.png
