kuniTN/rescue_tanaka_works/kicad/project/switching_board/reference/ref1_FETのゲート抵抗の決め方_files/7c2c84b2c8df7035f51b97bd18faab8f.png

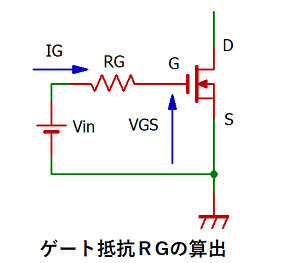
kicad/project/switching_board/reference/ref1_FETのゲート抵抗の決め方_files/7c2c84b2c8df7035f51b97bd18faab8f.png
