kuniTN/rescue_tanaka_works/kicad/project/switching_board/reference/ref1_FETのゲート抵抗の決め方_files/344c49cc4950b08a0060a81df71fdb5a-1.png

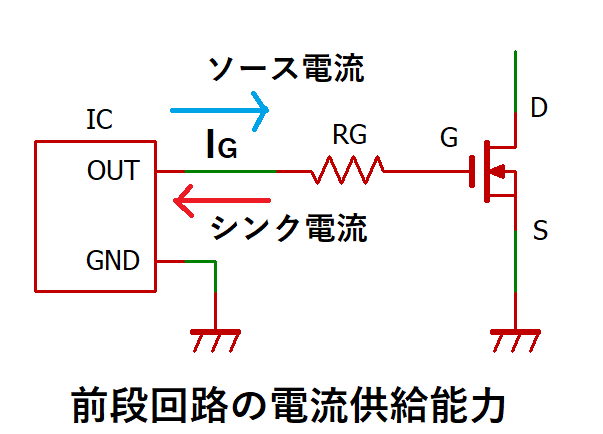
kicad/project/switching_board/reference/ref1_FETのゲート抵抗の決め方_files/344c49cc4950b08a0060a81df71fdb5a-1.png
