kuniTN/rescue_tanaka_works/kicad/project/switching_board/reference/ref1_FETのゲート抵抗の決め方_files/937b2d6fd04170dc83c808a040b2400a.png

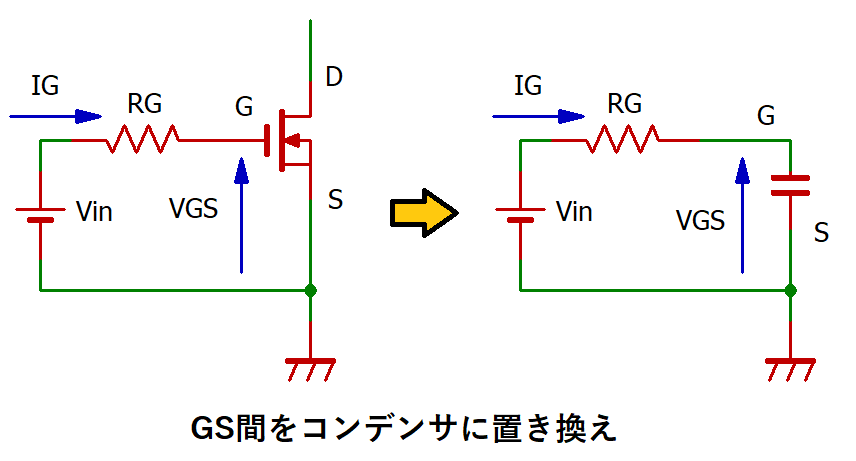
kicad/project/switching_board/reference/ref1_FETのゲート抵抗の決め方_files/937b2d6fd04170dc83c808a040b2400a.png
