kuniTN/rescue_tanaka_works/kicad/project/switching_board/reference/ref1_FETのゲート抵抗の決め方_files/22875a7615b6ebd21725966c6e50a402-1024x538.png

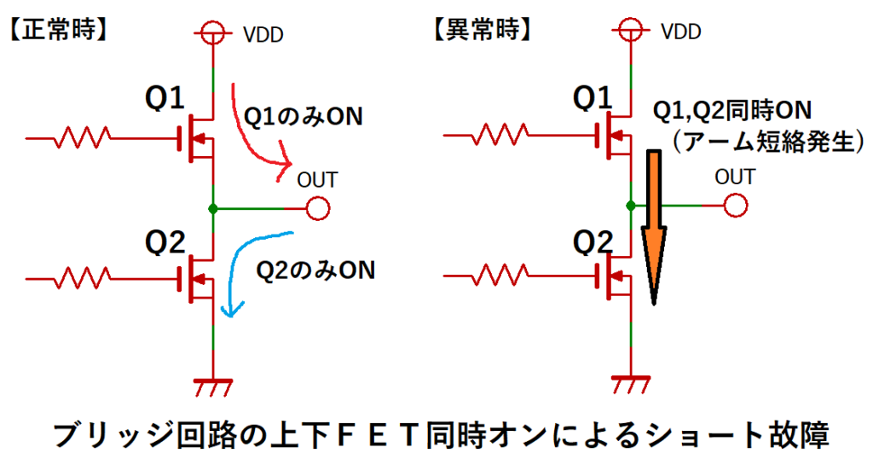
kicad/project/switching_board/reference/ref1_FETのゲート抵抗の決め方_files/22875a7615b6ebd21725966c6e50a402-1024x538.png
