kuniTN/rescue_tanaka_works/kicad/project/switching_board/reference/ref1_FETのゲート抵抗の決め方_files/b640b6cc25c4dc8a12b63315f9f6feb7.png

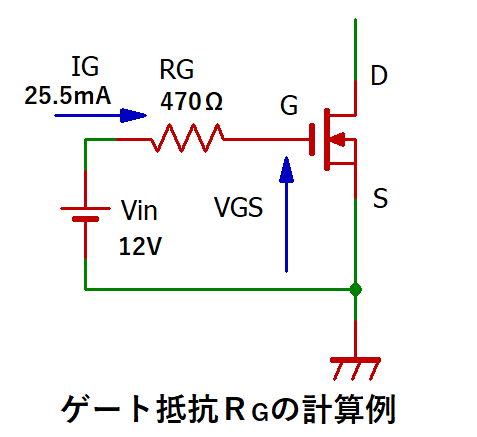
kicad/project/switching_board/reference/ref1_FETのゲート抵抗の決め方_files/b640b6cc25c4dc8a12b63315f9f6feb7.png
