kuniTN/rescue_tanaka_works/kicad/project/switching_board/reference/ref1_FETのゲート抵抗の決め方_files/c9ded76b522f870ed9e7b31522074ca7-2.png

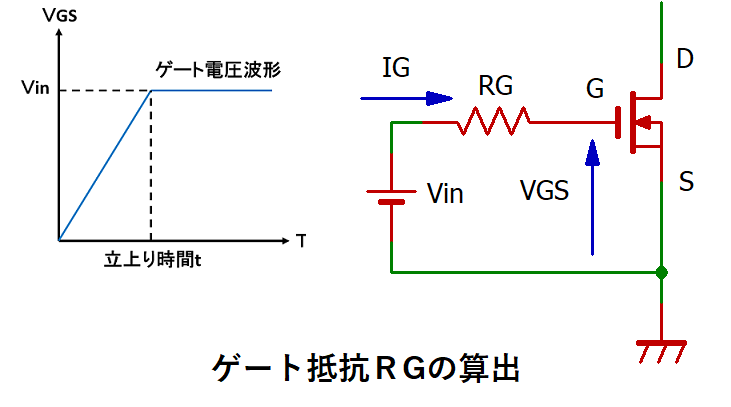
kicad/project/switching_board/reference/ref1_FETのゲート抵抗の決め方_files/c9ded76b522f870ed9e7b31522074ca7-2.png
