kuniTN/rescue_tanaka_works/kicad/project/switching_board/reference/ref1_FETのゲート抵抗の決め方_files/f2c9413b303feae0aa55336ebe7cc5b2.png

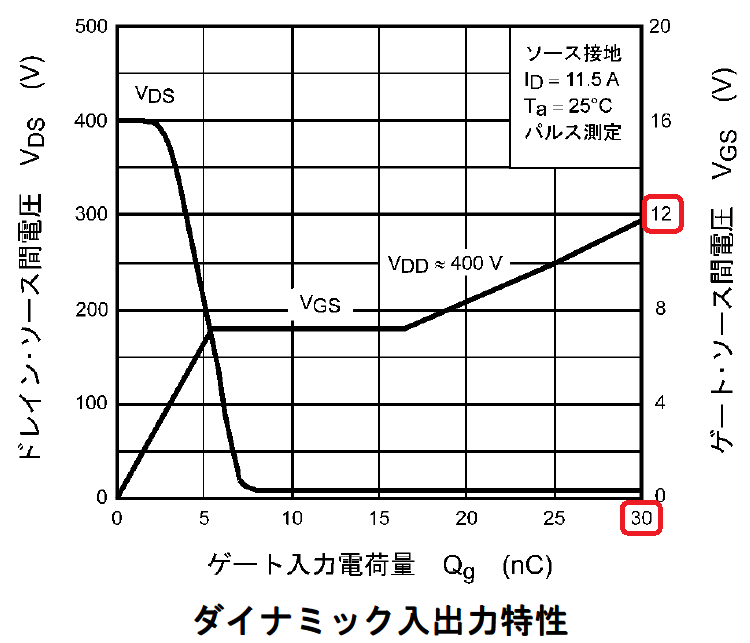
kicad/project/switching_board/reference/ref1_FETのゲート抵抗の決め方_files/f2c9413b303feae0aa55336ebe7cc5b2.png
