kuniTN/rescue_tanaka_works/kicad/project/switching_board/reference/ref1_FETのゲート抵抗の決め方_files/f5ee4f029ecf0a422e6c1bcc03df3bab.png

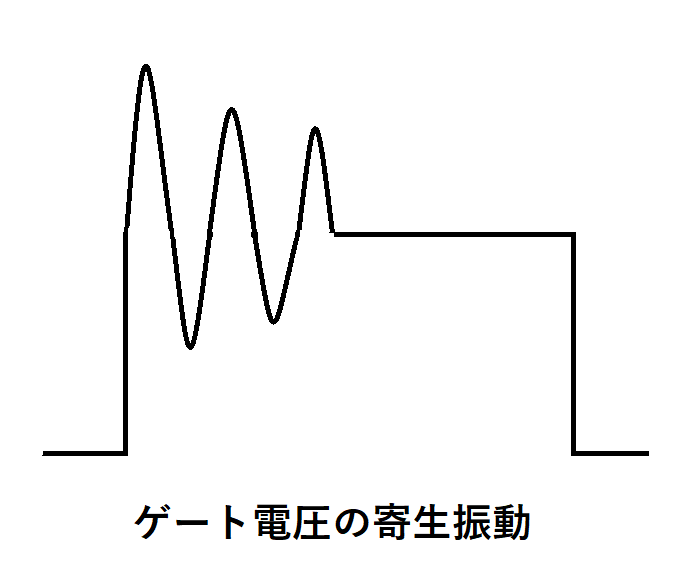
kicad/project/switching_board/reference/ref1_FETのゲート抵抗の決め方_files/f5ee4f029ecf0a422e6c1bcc03df3bab.png
