kuniTN/rescue_tanaka_works/kicad/project/switching_board/reference/ref1_FETのゲート抵抗の決め方_files/fe745cbedaea0dfbb0486a7a22af43a5-1024x560.png

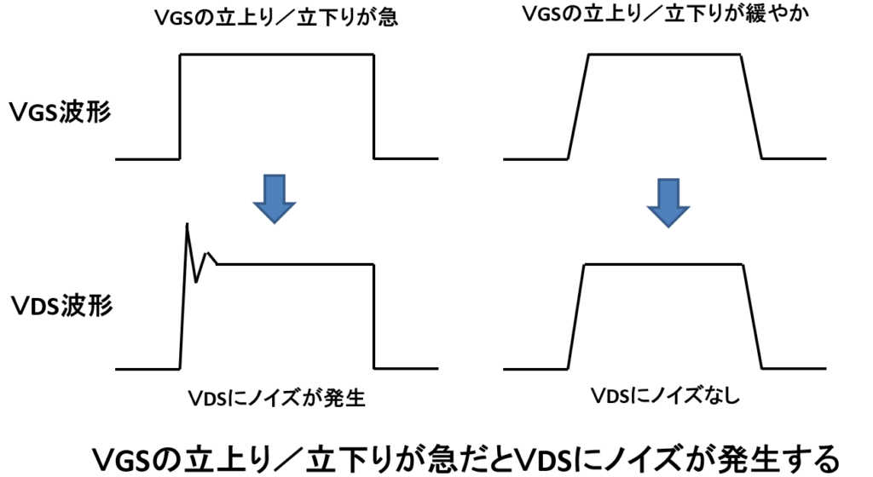
kicad/project/switching_board/reference/ref1_FETのゲート抵抗の決め方_files/fe745cbedaea0dfbb0486a7a22af43a5-1024x560.png
