kuniTN/rescue_tanaka_works/kicad/project/switching_board/reference/ref2_FETのゲート・ソース間抵抗の決め方_files/7ab7265e8191af4bffb2a216897fb77a-1-1024x400.png

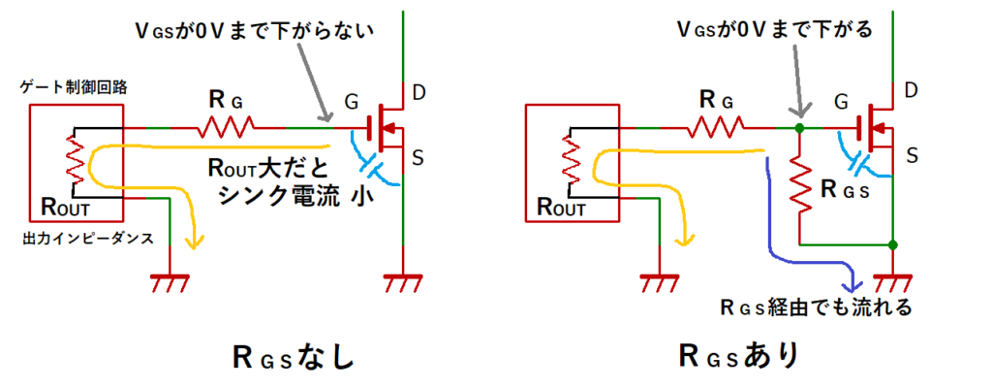
kicad/project/switching_board/reference/ref2_FETのゲート・ソース間抵抗の決め方_files/7ab7265e8191af4bffb2a216897fb77a-1-1024x400.png
