kuniTN/rescue_tanaka_works/kicad/project/switching_board/reference/ref2_FETのゲート・ソース間抵抗の決め方_files/000889a3a0e5e310f2a4bc08dbb0759a.png

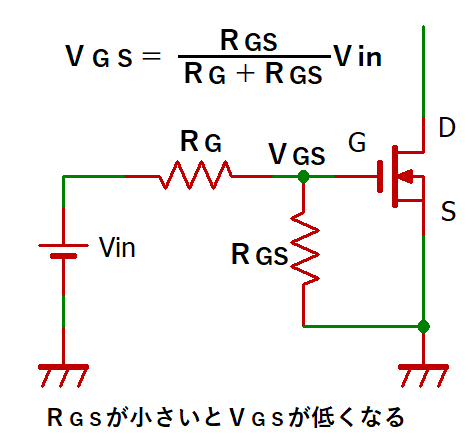
kicad/project/switching_board/reference/ref2_FETのゲート・ソース間抵抗の決め方_files/000889a3a0e5e310f2a4bc08dbb0759a.png
