kuniTN/rescue_tanaka_works/kicad/project/switching_board/reference/ref2_FETのゲート・ソース間抵抗の決め方_files/a2b572991bf748dd7263ee8bfffe95ca-1024x399.png

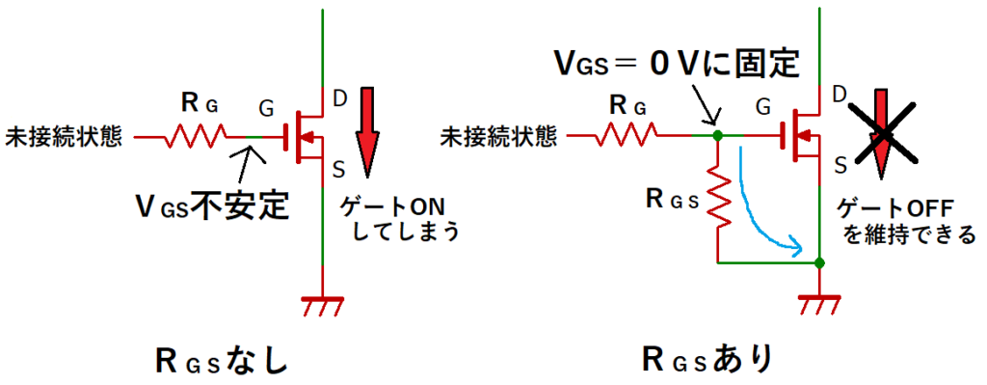
kicad/project/switching_board/reference/ref2_FETのゲート・ソース間抵抗の決め方_files/a2b572991bf748dd7263ee8bfffe95ca-1024x399.png
