kuniTN/rescue_tanaka_works/kicad/project/switching_board/reference/ref2_FETのゲート・ソース間抵抗の決め方_files/a24dc06970404b3a7a4e71a4961cc1aa.png

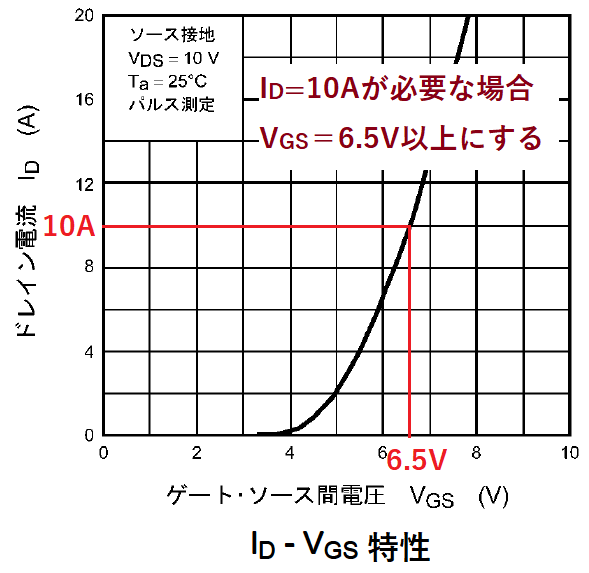
kicad/project/switching_board/reference/ref2_FETのゲート・ソース間抵抗の決め方_files/a24dc06970404b3a7a4e71a4961cc1aa.png
