kuniTN/rescue_tanaka_works/kicad/project/switching_board/reference/ref2_FETのゲート・ソース間抵抗の決め方_files/badb1c4af1adf1adbcdb4152866b057d.png

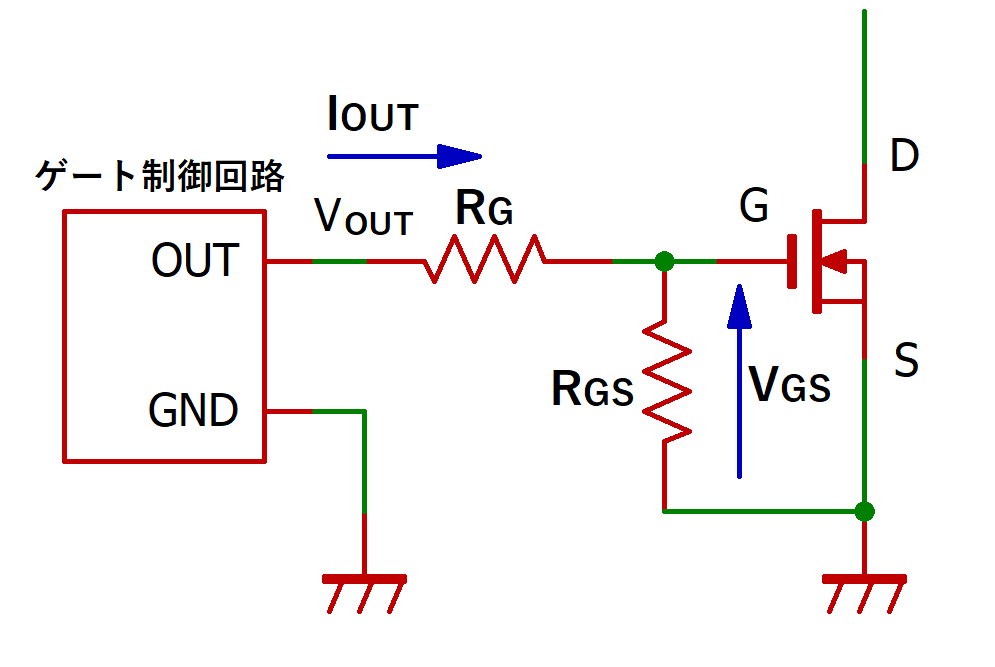
kicad/project/switching_board/reference/ref2_FETのゲート・ソース間抵抗の決め方_files/badb1c4af1adf1adbcdb4152866b057d.png
