kuniTN/rescue_tanaka_works/kicad/project/switching_board/reference/ref2_FETのゲート・ソース間抵抗の決め方_files/e1cfb4977c2f0cad6e1ab5e737670f40.png

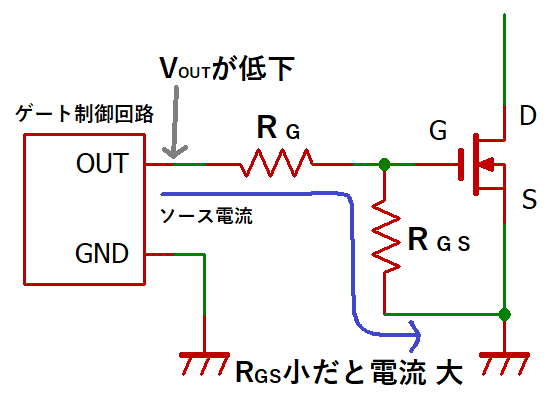
kicad/project/switching_board/reference/ref2_FETのゲート・ソース間抵抗の決め方_files/e1cfb4977c2f0cad6e1ab5e737670f40.png
