kuniTN/rescue_tanaka_works/kicad/project/switching_board/reference/ref2_FETのゲート・ソース間抵抗の決め方_files/fda701e5c78c643194304c5f8f8acfd0.png

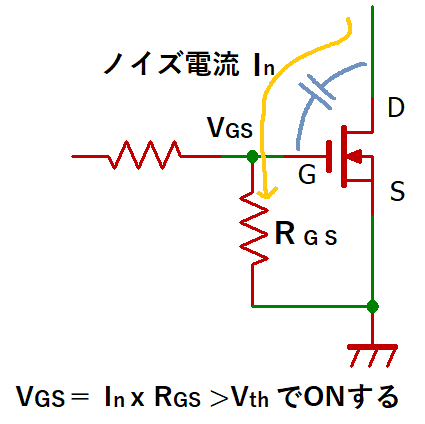
kicad/project/switching_board/reference/ref2_FETのゲート・ソース間抵抗の決め方_files/fda701e5c78c643194304c5f8f8acfd0.png
