kuniTN/rescue_tanaka_works/kicad/project/switching_board/reference/ref3_トランジスタ・FETの選定_files/7e0b9d2b8f82bd4993028c1264ac9829.png

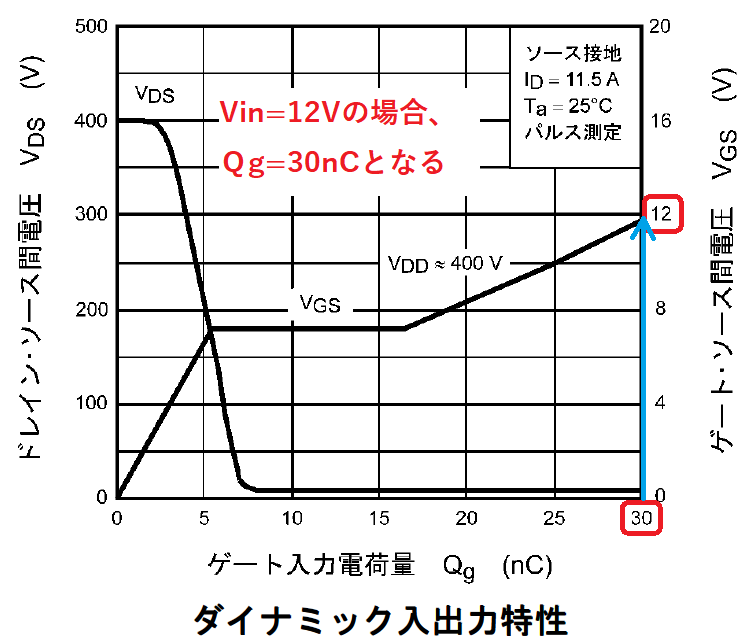
kicad/project/switching_board/reference/ref3_トランジスタ・FETの選定_files/7e0b9d2b8f82bd4993028c1264ac9829.png
