kuniTN/rescue_tanaka_works/kicad/project/switching_board/reference/ref3_トランジスタ・FETの選定_files/124d9be1d0571032f0b169d032f65ebe-1024x374.png

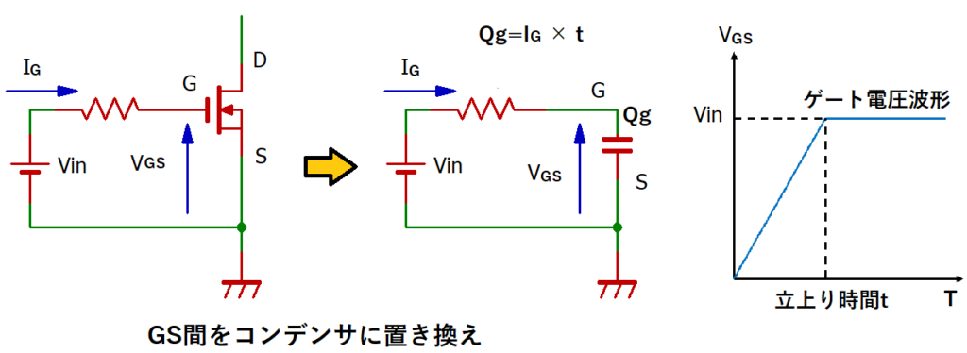
kicad/project/switching_board/reference/ref3_トランジスタ・FETの選定_files/124d9be1d0571032f0b169d032f65ebe-1024x374.png
