kuniTN/rescue_tanaka_works/kicad/project/switching_board/reference/ref3_トランジスタ・FETの選定_files/7926062fd9d3ea5538efeae356ad6a83.png

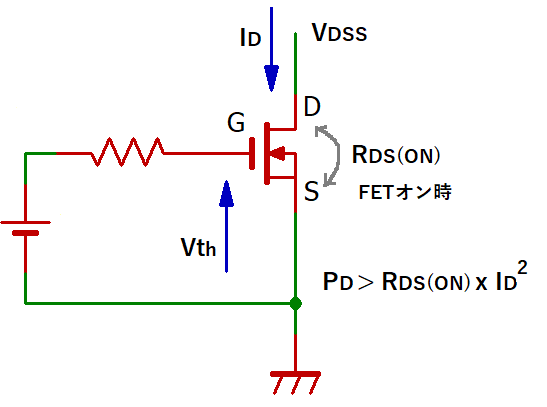
kicad/project/switching_board/reference/ref3_トランジスタ・FETの選定_files/7926062fd9d3ea5538efeae356ad6a83.png
