kuniTN/rescue_tanaka_works/kicad/project/switching_board/reference/ref3_トランジスタ・FETの選定_files/21251049112eb8838ddb6d6ea594a7c2.png

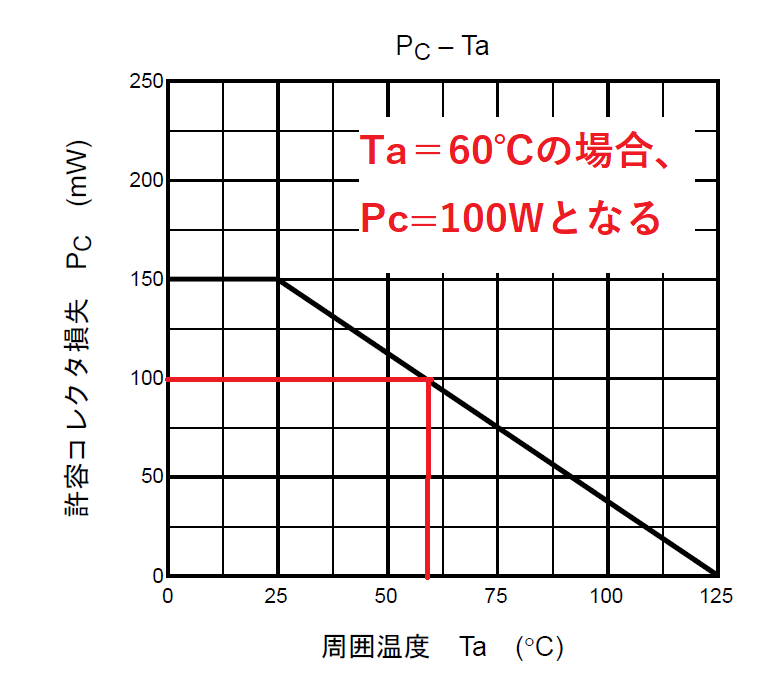
kicad/project/switching_board/reference/ref3_トランジスタ・FETの選定_files/21251049112eb8838ddb6d6ea594a7c2.png
