kuniTN/rescue_tanaka_works/kicad/project/switching_board/reference/ref3_トランジスタ・FETの選定_files/a6718736751dc4cb9611734dc6f9e97d.png

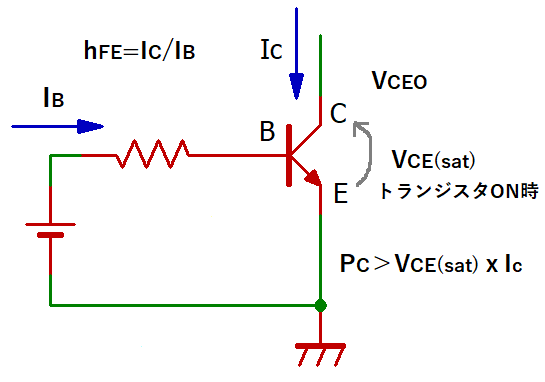
kicad/project/switching_board/reference/ref3_トランジスタ・FETの選定_files/a6718736751dc4cb9611734dc6f9e97d.png
