kuniTN/rescue_tanaka_works/kicad/project/switching_board/reference/ref3_トランジスタ・FETの選定_files/aaaa6f5dd10a47f99ba0eb779e686872.png

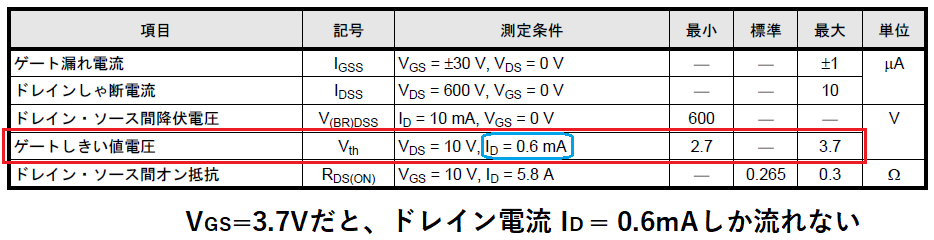
kicad/project/switching_board/reference/ref3_トランジスタ・FETの選定_files/aaaa6f5dd10a47f99ba0eb779e686872.png
