kuniTN/rescue_tanaka_works/kicad/project/switching_board/reference/ref3_トランジスタ・FETの選定_files/c3b6ffa25934cd919cadafca4ab7ac88-1024x495.png

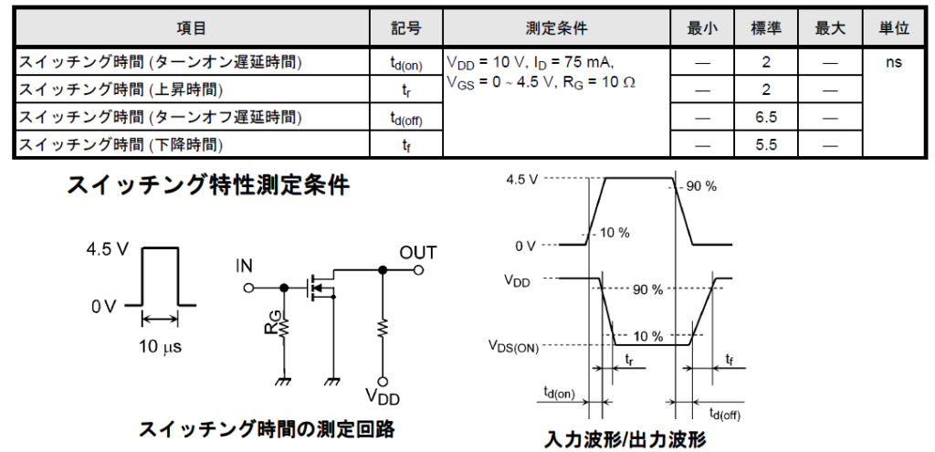
kicad/project/switching_board/reference/ref3_トランジスタ・FETの選定_files/c3b6ffa25934cd919cadafca4ab7ac88-1024x495.png
