kuniTN/rescue_tanaka_works/kicad/project/switching_board/reference/ref3_トランジスタ・FETの選定_files/c90f5652b4029986c19c66396904fa85.png

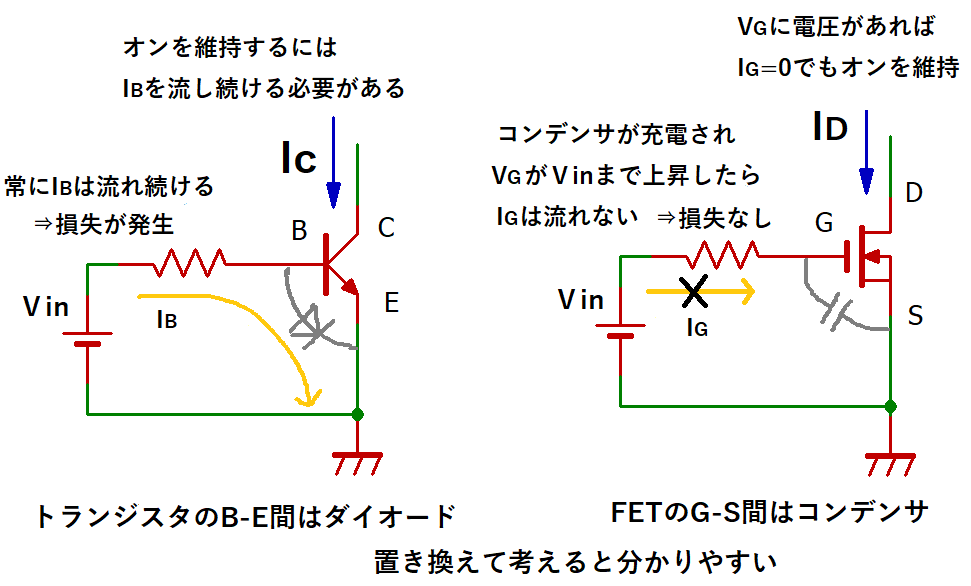
kicad/project/switching_board/reference/ref3_トランジスタ・FETの選定_files/c90f5652b4029986c19c66396904fa85.png
