kuniTN/rescue_tanaka_works/kicad/project/switching_board/reference/ref3_トランジスタ・FETの選定_files/e346e61324c252287ed307c95a9c5e33.png

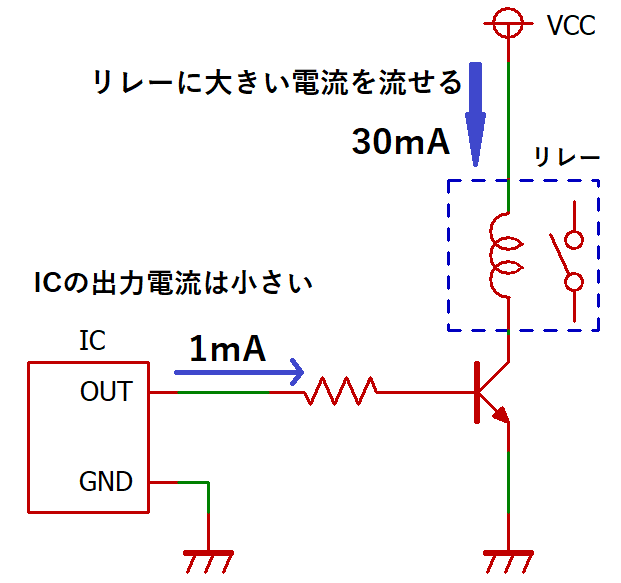
kicad/project/switching_board/reference/ref3_トランジスタ・FETの選定_files/e346e61324c252287ed307c95a9c5e33.png
