kuniTN/rescue_tanaka_works/kicad/project/switching_board/reference/ref3_トランジスタ・FETの選定_files/f5409e6f41c6d5515ab742630e8f4435-1.png

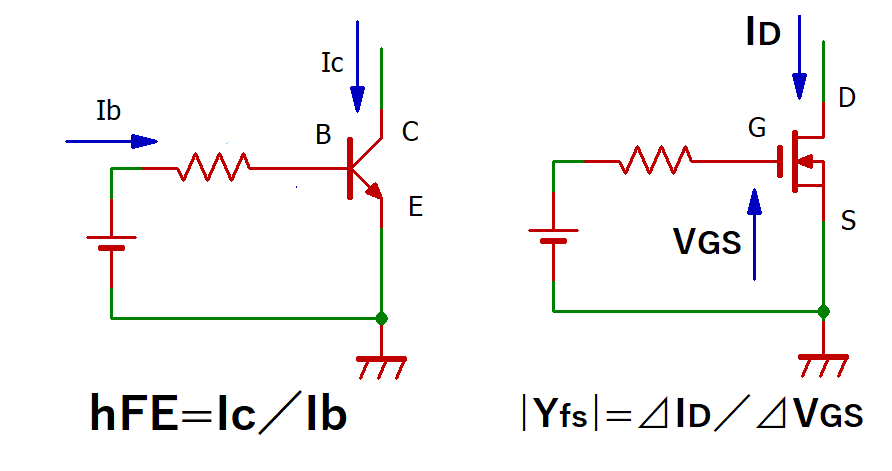
kicad/project/switching_board/reference/ref3_トランジスタ・FETの選定_files/f5409e6f41c6d5515ab742630e8f4435-1.png
