kuniTN/rescue_tanaka_works/kicad/project/switching_board/reference/ヒューズ選定手順_files/J_fuse_selection_process_02-e1545804880185.png

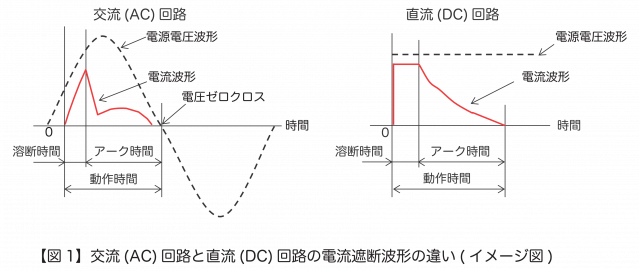
kicad/project/switching_board/reference/ヒューズ選定手順_files/J_fuse_selection_process_02-e1545804880185.png
