kuniTN/rescue_tanaka_works/kicad/project/switching_board/reference/ヒューズ選定手順_files/J_fuse_selection_process_16-e1545805156501.png

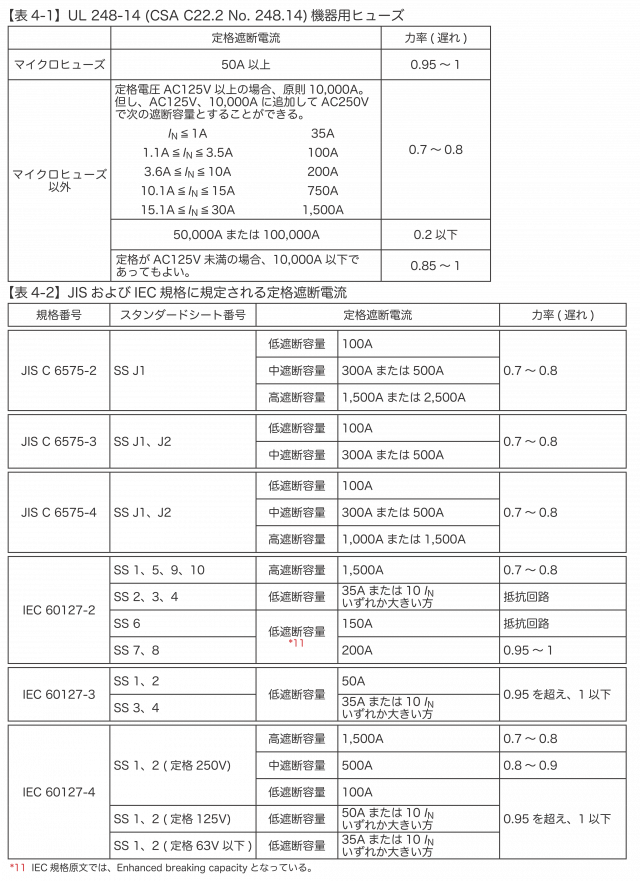
kicad/project/switching_board/reference/ヒューズ選定手順_files/J_fuse_selection_process_16-e1545805156501.png
