kuniTN/rescue_tanaka_works/kicad/project/switching_board/reference/ヒューズ選定手順_files/J_fuse_selection_process_17-e1545805189901.png

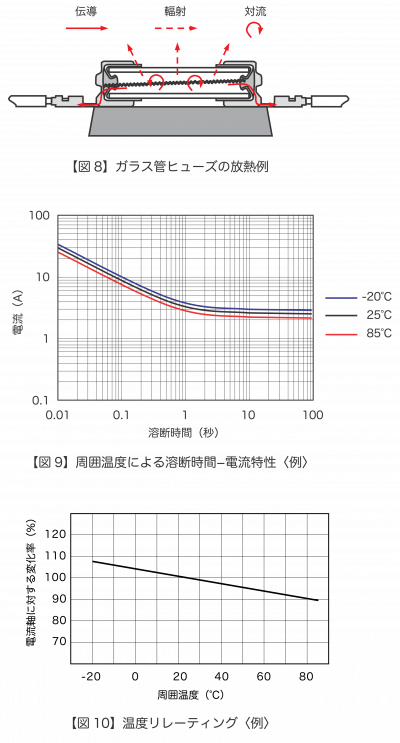
kicad/project/switching_board/reference/ヒューズ選定手順_files/J_fuse_selection_process_17-e1545805189901.png
