kuniTN/rescue_tanaka_works/kicad/project/switching_board/screen shots/fet回路記号.png

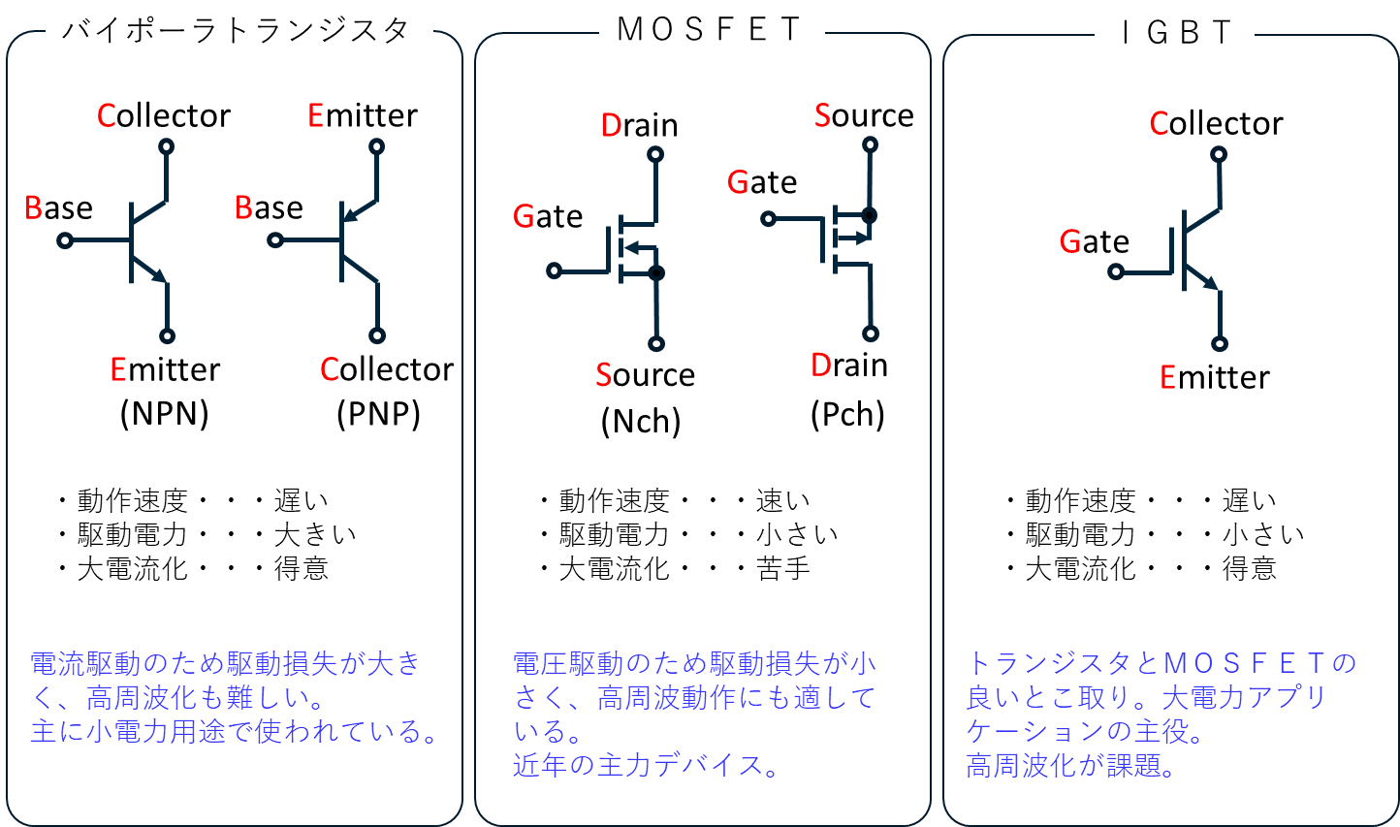
kicad/project/switching_board/screen shots/fet回路記号.png
