kuniTN/rescue_tanaka_works/kicad/project/switching_board/screen shots/power output.PNG

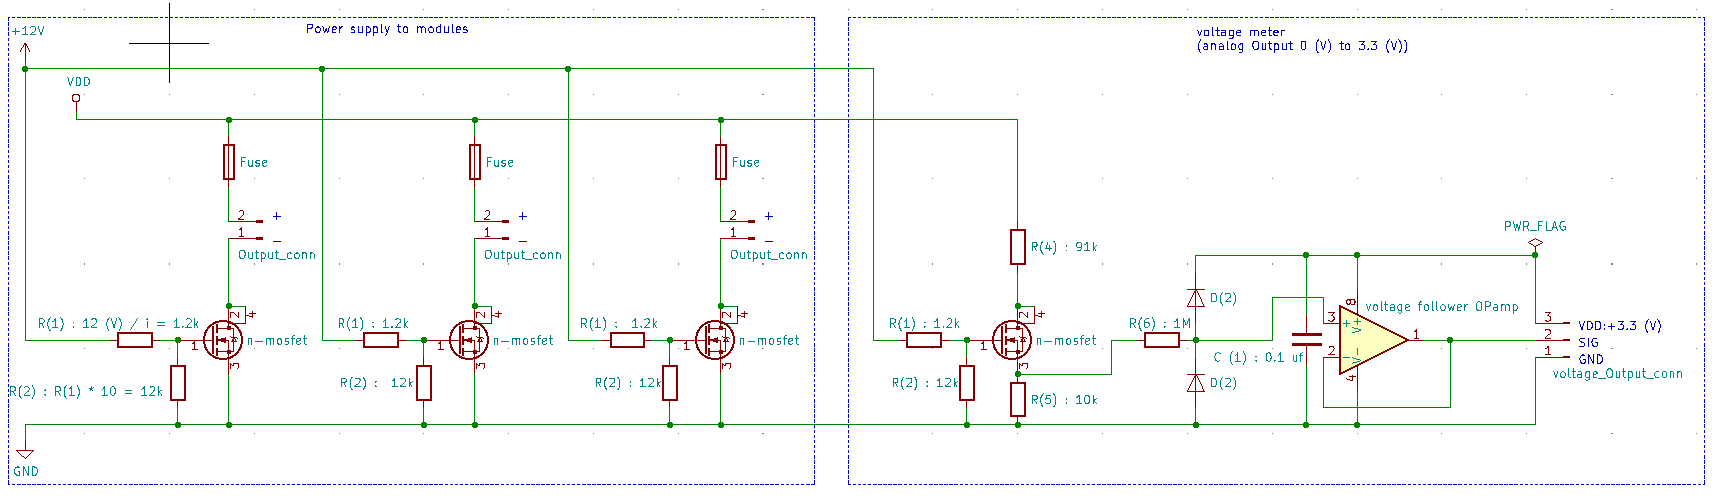
kicad/project/switching_board/screen shots/power output.PNG
