kuniTN/rescue_tanaka_works/kicad/project/switching_board/screen shots/ロボットシステム概略図ダメな例.png

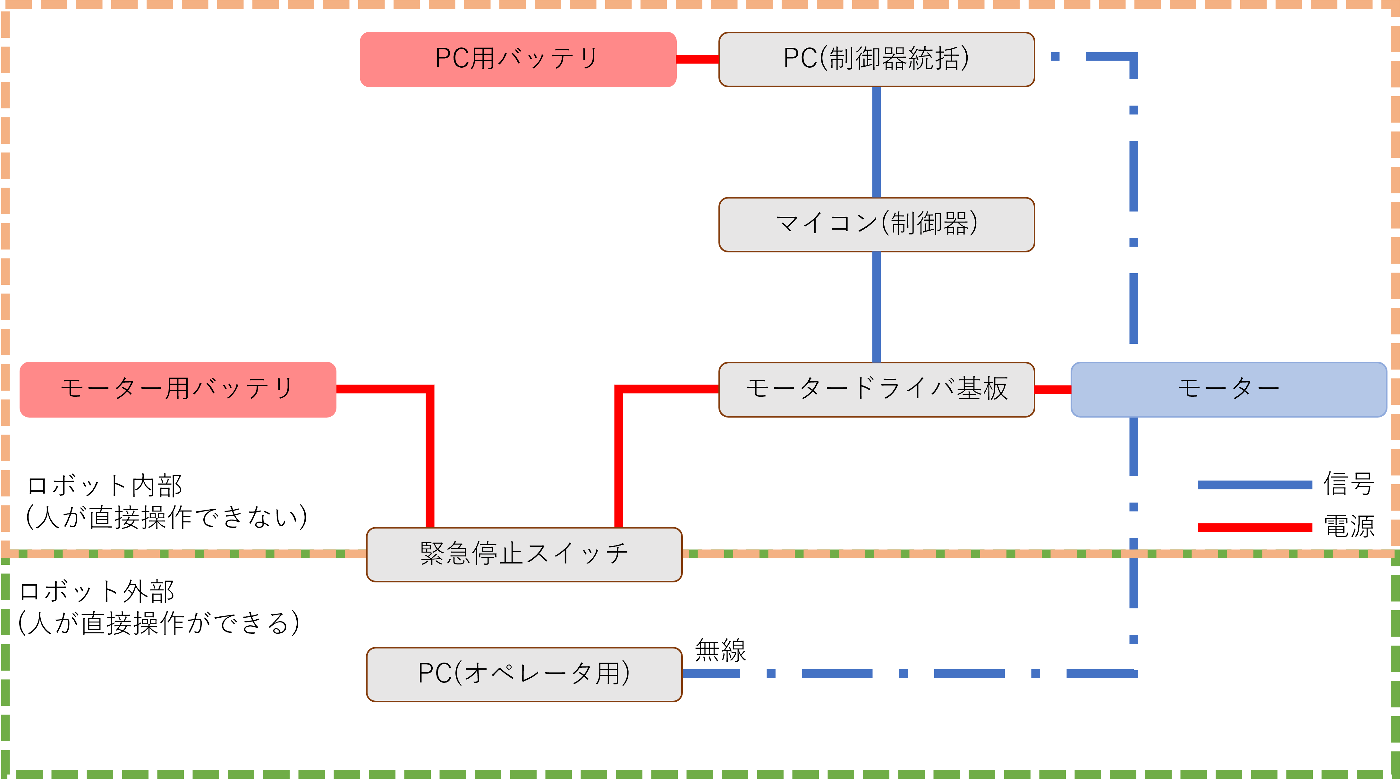
kicad/project/switching_board/screen shots/ロボットシステム概略図ダメな例.png
