kuniTN/rescue_tanaka_works/kicad/project/switching_board/screen shots/充電0.PNG

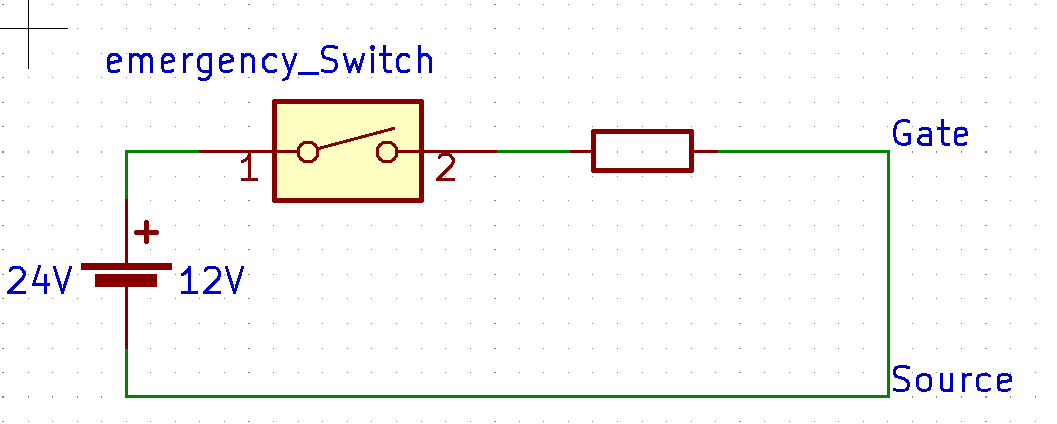
kicad/project/switching_board/screen shots/充電0.PNG
