kuniTN/rescue_tanaka_works/kicad/project/switching_board/スイッチング基板_回路図v1.1.0_20210707.pdf

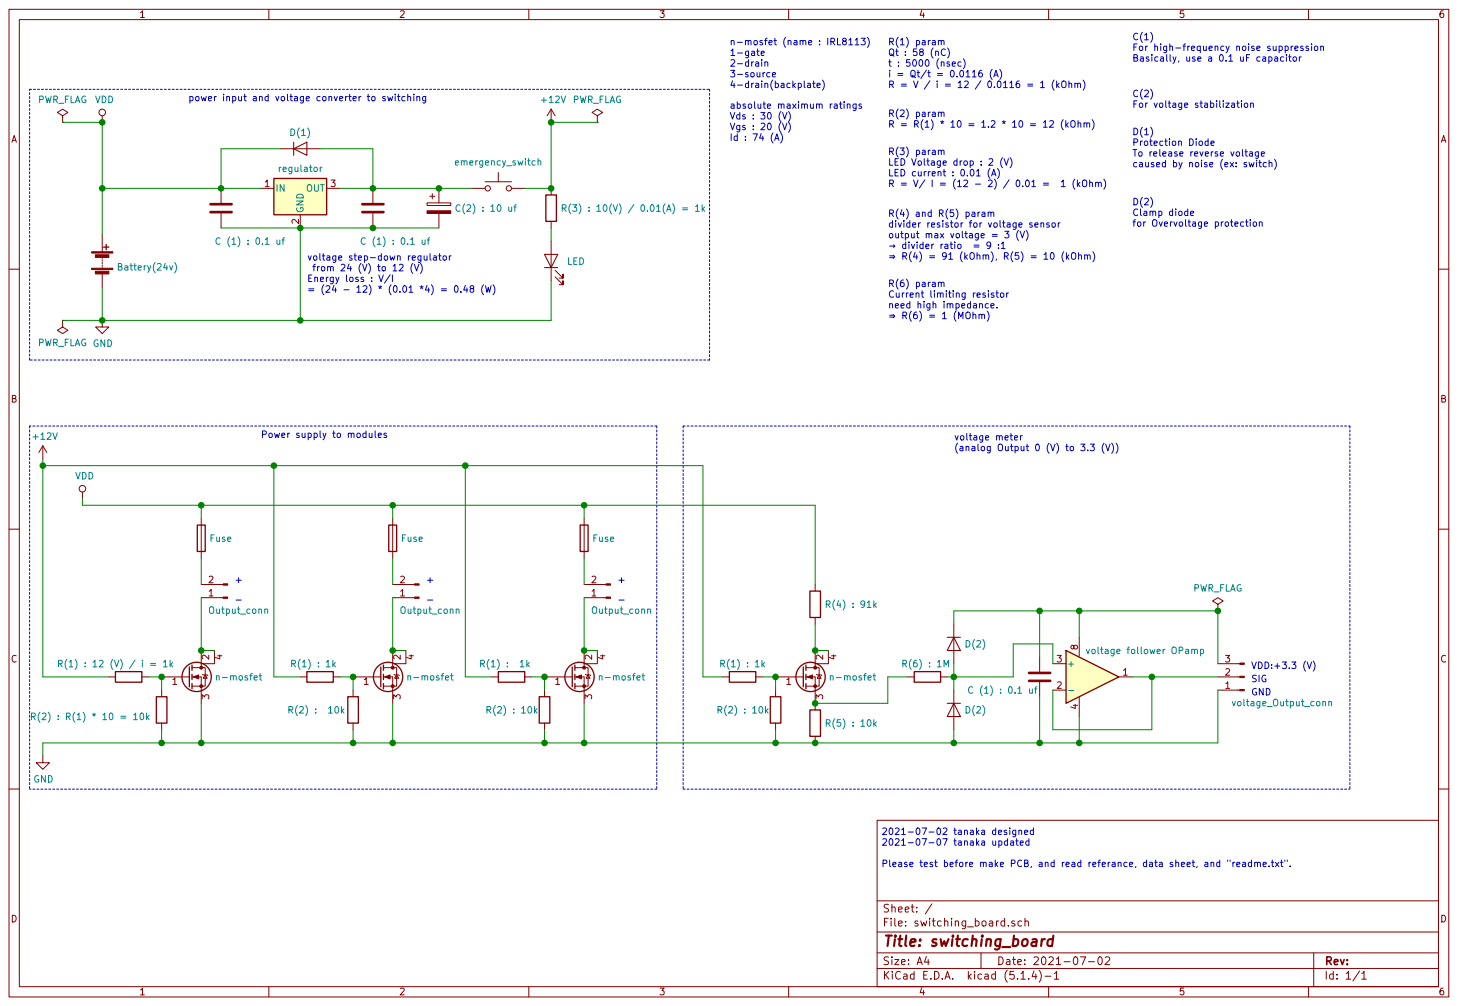
[picture p81: page 1]

For high-frequency noise suppression
Basically, use a 0.1 uF capacitor

power input and voltage converter to switching

D(1) Protection Diode To release reverse voltage

caused by noise (ex: switch)

R(4) and R(5) param
divider resistor for voltage sensor
output max voltage = 3 (V)
divider ratio = 9 :1
R(4) = 91 (kOhm), R(5) = 10 (kOhm)

voltage step-down regulator
from 24 (V) to 12 (V)
Energy loss : V/I

2021-07-02 tanaka designed
2021-07-07 tanaka updated Please test before make PCB, and read referance, data sheet, and "readme.txt".
