kuniTN/rescue_tanaka_works/kicad/project/switching_board/スイッチング基板_回路図v1.0.0_20210707.pdf

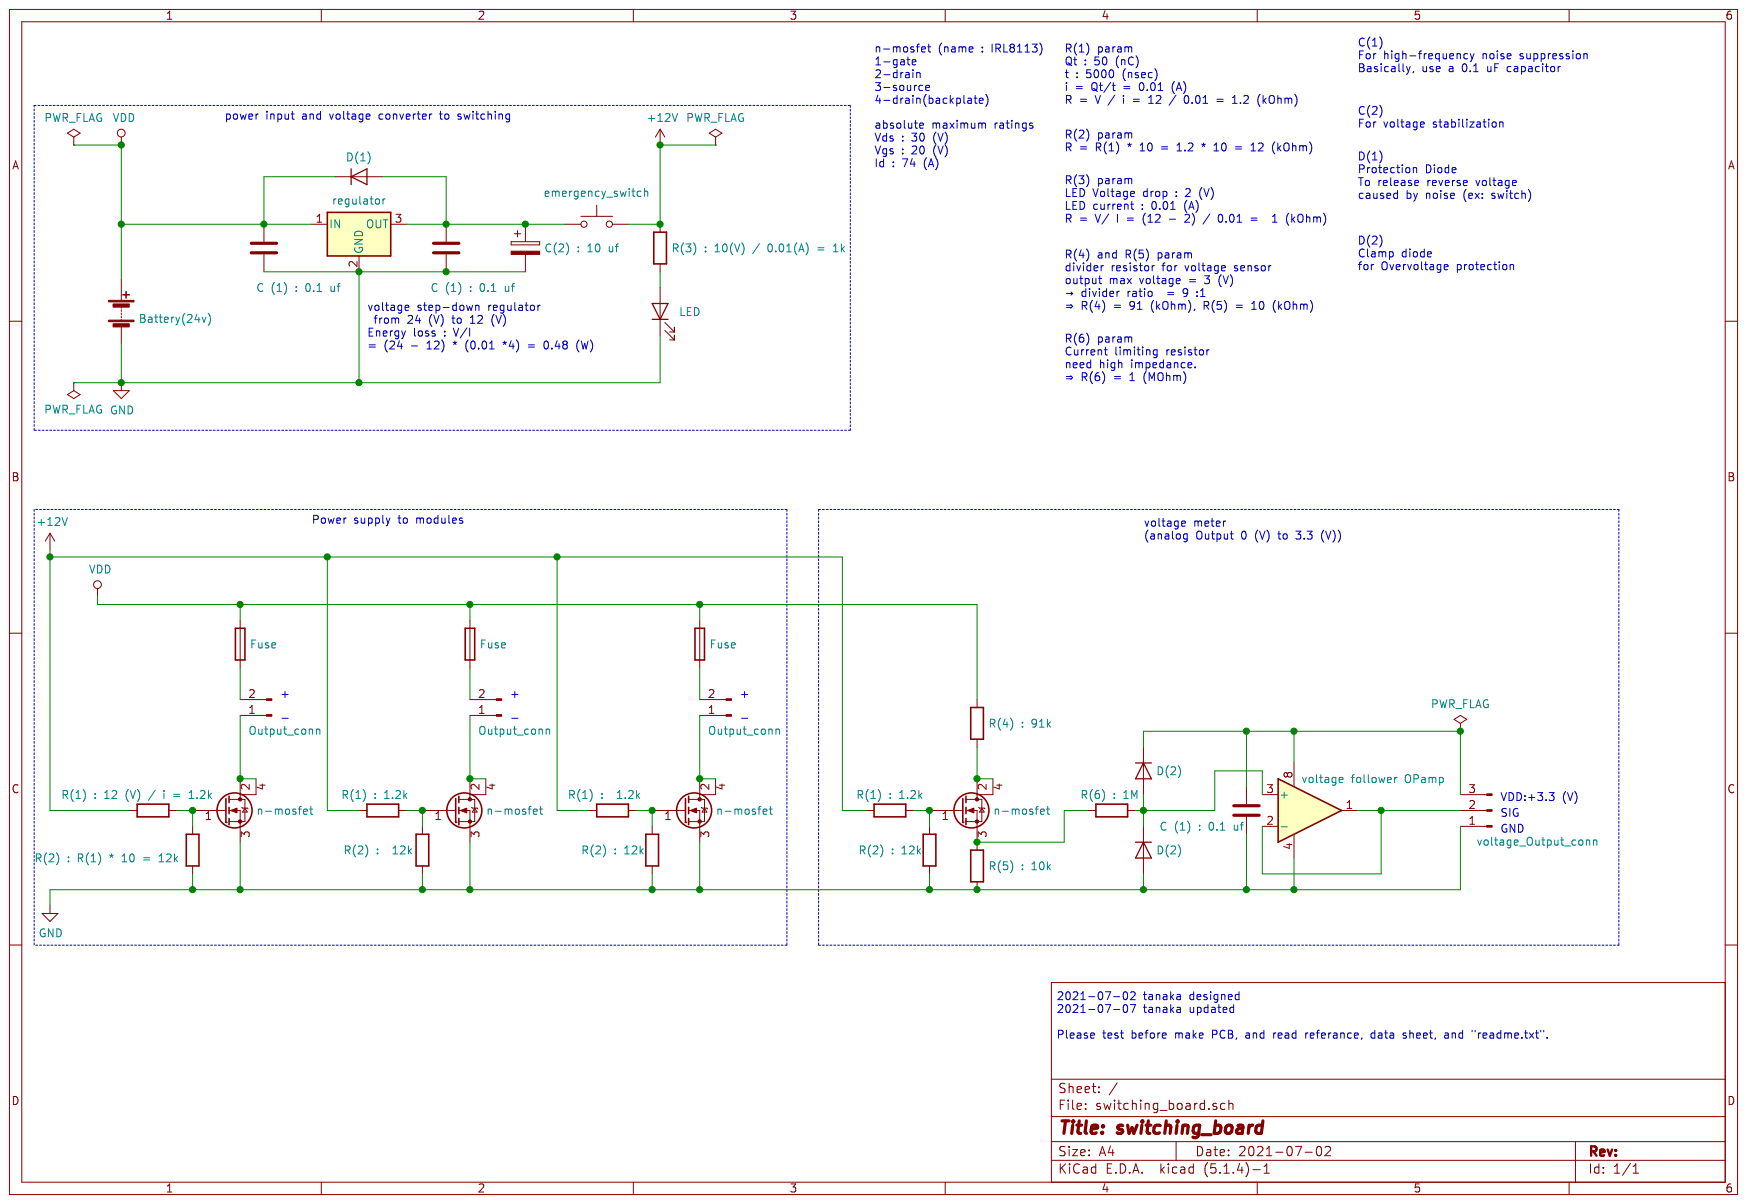
[picture p82: page 1]
