kuniTN/rescue_tanaka_works/kicad/project/switching_board/ltspice_test/voltage_output.asc

C1: cap; 0.1µ
D1: diode
D2: diode
M1: nmos; IRF6607
M2: nmos; IRF6607
R1: res; 1.2k
R2: res; 12k
R3: res; 5; tol=1 pwr=0.1
R4: res; 1.2k
R5: res; 12k
R6: res; 10k
R7: res; 91k
R8: res; 1m
U2: OP07
V1: voltage; 24
V2: voltage; SINE(0 12 0.05 1n 1n 20)
V3: voltage; 3.3
Named nets: 0, R7out, R6out, R9in, sig, v12, R7in, R6in
.tran 600
