kuniTN/rescue_tanaka_works/(commit log)

2021-07-11 ドキュメント更新テスト
2021-07-11 説明資料アップデート
    [switching_board.sch]
2021-07-12 スイッチング基板解説書第一版アップ
